laurenpearse/Stage-Top-Incubator/hardware/README.md

# Hardware

- `cad/stage-top-incubator.step`: the 3D-printed PETG enclosure as a STEP file, which opens in most CAD programs (Fusion 360, SolidWorks, FreeCAD, Onshape).
- `bom/initial-component-list-2026-08-27.pdf`: the first component list from August. The final bill of materials (R 13 527) and the full wiring list are in the appendices of the report.

The heater driver and thermistor divider circuits are drawn in the report.
