laurenpearse/Stage-Top-Incubator/report/v_glossary.tex

%---------------------------------------------------------------------
%	List of Acronyms
%   A plain table rather than the glossaries package, so the list prints
%   on any compiler without makeglossaries. Keep it alphabetical, and
%   define each acronym in the text the first time it is used.
%---------------------------------------------------------------------
\chapter{List of Acronyms}
\label{ch:gloss}
\small
\renewcommand{\arraystretch}{1.12}
\begin{longtable}{@{}p{2.4cm} p{0.75\textwidth}@{}}
\toprule
\textbf{Acronym} & \textbf{Meaning} \\
\midrule
\endfirsthead
\toprule
\textbf{Acronym} & \textbf{Meaning} \\
\midrule
\endhead
\bottomrule
\endlastfoot
ACH & Air changes per hour \\
ADC & Analogue-to-digital converter \\
AI & Artificial intelligence \\
ANSI & American National Standards Institute \\
ASTM & ASTM International (formerly American Society for Testing and Materials) \\
BOM & Bill of materials \\
BSL & Biosafety level \\
CAD & Computer-aided design \\
DIY & Do-it-yourself \\
ECSA & Engineering Council of South Africa \\
FOPDT & First order plus dead time \\
FPU & Floating point unit \\
GA & Graduate Attribute \\
I\textsuperscript{2}C & Inter-integrated circuit (serial bus) \\
IDM & Institute of Infectious Disease and Molecular Medicine \\
IEC & International Electrotechnical Commission \\
ITO & Indium tin oxide \\
MMRU & Molecular Mycobacteriology Research Unit \\
MOSFET & Metal-oxide-semiconductor field-effect transistor \\
Mtb & \textit{Mycobacterium tuberculosis} \\
NDIR & Non-dispersive infrared \\
NO & Normally open (relay contact) \\
NTC & Negative temperature coefficient (thermistor) \\
PCB & Printed circuit board \\
PET & Polyethylene terephthalate \\
PETG & Polyethylene terephthalate glycol \\
PI & Proportional-integral \\
PID & Proportional-integral-derivative \\
pp & Percentage points \\
ppm & Parts per million \\
PTC & Positive temperature coefficient \\
PWM & Pulse-width modulation \\
QFT & Quantitative feedback theory \\
RC & Resistance-capacitance (thermal network) \\
RH & Relative humidity \\
RTD & Resistance temperature detector \\
SLAS & Society for Laboratory Automation and Screening \\
SPI & Serial peripheral interface \\
UART & Universal asynchronous receiver-transmitter \\
UCT & University of Cape Town \\
ZAR & South African rand \\
\end{longtable}
\normalsize
