laurenpearse/Stage-Top-Incubator/docs/thesis/latex/0_titlepage.tex

%=====================================================================
%	TITLE PAGE
%=====================================================================
\begin{titlepage}
    \centering
    \vspace*{0cm}

    % Title
    {\huge\bfseries \titl\par}
    \vskip 0.5cm

    % Subtitle
    {\Large \subtitle\par}
    \vskip 0.8cm

    % UCT logo
    \logo

    \vskip 0.8cm

    % Author
    {\Large\bfseries \auth\par}
    \vskip 2mm
    {\normalsize \studentnumber\par}

    % Author's address
    \vskip 2mm
    {\normalsize
        \dept\\*
        \uni\\*
        \city\\*
        \country\par}

    \vskip 0.6cm

    % Supervisor
    {\normalsize
        {\itshape Supervisor}\\*
        \supervisor\par}
    \vskip 0.2cm

    % Co-supervisor
    {\normalsize
        {\itshape Co-supervisor}\\*
        \cosupervisor\par}
    \vskip 0.6cm

    % Date
    {\Large\bfseries \MonthYear\par}
    \vskip 0.5cm

    % Degree
    {\normalsize A \documenttype\ submitted in partial fulfilment of the requirements for the degree of \degreee\ (\degreeabv) in the \dept\ at the \uni.\par}

    \vskip 0.5cm

    \vfill

    % Department logo
    \bottomlogos
\end{titlepage}
