laurenpearse/Stage-Top-Incubator/docs/thesis/latex/A_gitrepo.tex

%---------------------------------------------------------------------
% Appendix: GitHub repository
%---------------------------------------------------------------------
\chapter{GitHub Repository}
\label{app:github}

The firmware, MATLAB and Simulink models, analysis scripts, test data and CAD files for the enclosure are in the project repository:

\begin{center}
    \gitrepo
\end{center}

% TODO: list the top-level folders of the repository here once the link is
% in, e.g. firmware/, simulation/, analysis/, data/, cad/, with one line on
% what each holds, so an examiner can find the code behind each chapter.
