laurenpearse/Stage-Top-Incubator/notes/CO2 Path.pdf

## CO2 Path

^^ first thing i want to have standard sizing throughout, ideally just want one tube size ^^ first gonna see what size the bigger components come in and try pick the same

## CO2 Gas Cost

according to Air Products 2026 price list:
about: R1800

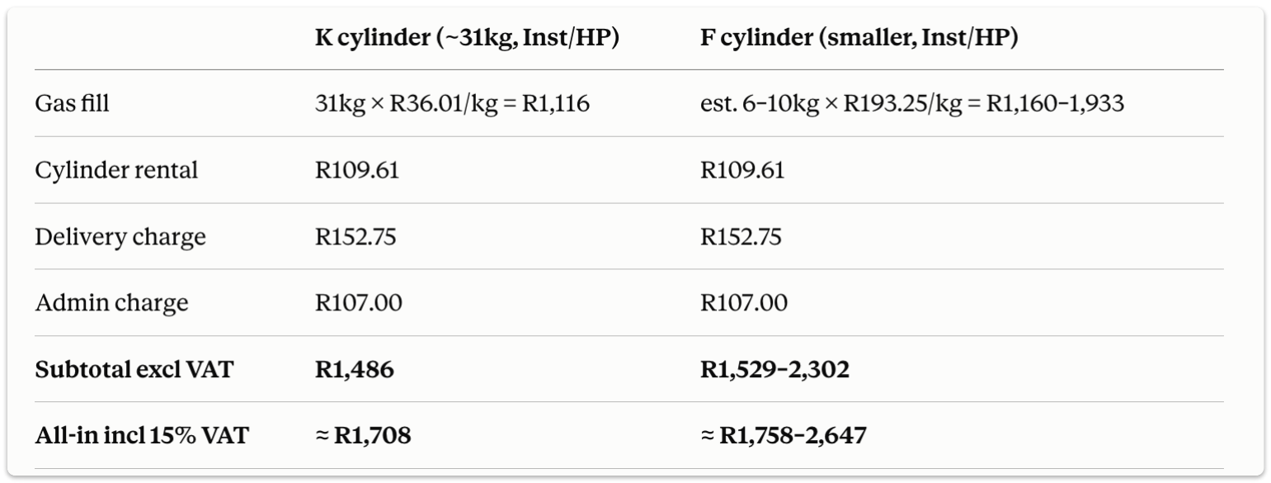
[picture p18: figure]

## 50 000ppm CO2 sensor

## Pressure Regulator

GCE Pressure Regulator Co2, Ar 5/8 in G BSP - R1950 - https://za.rs-online.com/web/p/welding-regulators/0340129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 wcB (https://za.rs-online.com/web/p/welding-regulators/0340129?matchtype=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)

## Solenoid Valve

SMC Solenoid Valve - NC 24V - R1037 - https://za.rs-online.com/web/p/pneumaticsolenoid-valves/0425481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 (https://za.rs-online.com/web/p/pneumatic-solenoid-valves/0425481?matchtype=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)

1. R2162 only reads up to 50000ppm so won't know if overshoot (only reads up to 5%) https://www.robotics.org.za/sensors/co2-sensors/SEN0220
2. R3467 - this CO2 sensor reads up to 100% concentration apparently - https://za.rs-online.com/web/p/environmental-sensor-ics/1809026 (https://za.rs-online.com/web/p/environmental-sensor-ics/1809026)

AIdOaXzb1vUsxvDIeOKC1ISHqEjizdmNSuDv_JVTC_cY6xhKBxMwfqbtBQ0aAnsaEALw_wc
B (https://za.rs-online.com/web/p/pneumatic-solenoid-valves/0425481?matchtype=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)

## Flow control/needle valve Check valve

^^^ Option that Includes: Regulator, solenoid, needle valve, check valve

## Tubing

## Compression fitting / bulkhead connector

Bulkhead
Connector

RS PRO
PMM
Series
Pneumatic
Fitting, 6
mm Push-in, 6 mm
Push-in

RS
Online
2 | R134 | R268 | https://za.rs-onlin _-2351214&match rTUBhAiEiwADv8g (https://za.rs-online.com/web/p/pneumatic-fittings/2351214?matchtype=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)

regulator, solenoid, fine tune valve, check valve, Connector: G5/8 : R1628, https://mcmerwe.co.za/shop/lst-aqua-co2-dual-gauge-regulator/,
would rather go for this because it invludes a bunch of componentsd I need and in one unit that is proved to ork togteher - it's less expesnive and less risky and It is local so i can go fetch it myself and talk with the vendors to clarify it will work

for mcmerwe one - tube R75: https://mcmerwe.co.za/shop/aquapro-co2-pressureresistant-tube-3m/ (https://mcmerwe.co.za/shop/aquapro-co2-pressure-resistant-tube-3m/)
