laurenpearse/Stage-Top-Incubator/report/B_ethics.tex

%---------------------------------------------------------------------
% Appendix: Ethics approval
%---------------------------------------------------------------------
\chapter{Ethics Approval}
\label{app:ethics}

The project was submitted to the Faculty Research Ethics Committee pre-screening questionnaire before any testing began. The outcome letter (reference \ebeethicsnumber{}, 11 August 2026) confirms that a full ethics application was not needed. The letter is shown below.

\begin{center}
    \fbox{}
\end{center}
