laurenpearse/Stage-Top-Incubator/report/i_declaration.tex

%---------------------------------------------------------------------
%	Plagiarism Declaration
%   Wording follows the EEE4022S 2026 declaration issued by the course
%   convener, including the statement on the use of AI.
%---------------------------------------------------------------------
\chapter{Plagiarism Declaration}
\label{ch:decl}

\begin{enumerate}[label=\arabic*., leftmargin=*, itemsep=6pt]
    \item I know that plagiarism is wrong. Plagiarism is to use another's work and pretend that it is one's own.

    \item I have used the \textbf{IEEE} convention for citation and referencing. Each contribution to, and quotation in, this report from the work(s) of other people has been attributed, and has been cited and referenced. Any section taken from an internet source has been referenced to that source.

    \item This report is my own work, and is in my own words (except where I have attributed it to others).

\item \textbf{I have not paid a third party to complete my work on my behalf. My use of artificial intelligence software has been limited to} the use of Anthropic's Claude (claude.ai) as a writing, editing and coding aid. It was used to shorten and reword long passages and fix \LaTeX\ problems. It was also used to help write the STM32 code for reading the sensors and implementing the controllers, and to organise design notes into a more coherent form to write from. All engineering decisions, component selection, modelling, experiments, data and results are my own. Every AI-assisted passage and code section was checked against my data and sources and edited by me before it was included. Examples of the prompts used and the output received are given in Appendix~\ref{app:ai}.

    \item I have not allowed and will not allow anyone to copy my work with the intention of passing it off as his or her own work.

    \item I acknowledge that copying someone else's assignment or essay, or part of it, is wrong, and declare that this is my own work.
\end{enumerate}

\vfill
%---------------------------------------------------------------------
% WORD COUNT, PAGE COUNT AND SIGNATURE
%   Both counts are computed, not typed. See latexmkrc and 0_main.tex.
%---------------------------------------------------------------------
\noindent
\begin{minipage}[b]{0.55\textwidth}
\begin{tabular}{@{}ll@{}}
\textbf{Word count} & \wordcount{} words\\
\textbf{Page count} & \bodypages{} pages\\
\multicolumn{2}{@{}l}{\footnotesize (body chapters only, excluding preamble, appendices and bibliography)}
\end{tabular}
\end{minipage}\hfill
\begin{minipage}[b]{0.4\textwidth}
    \raggedleft
%   figs/signature.jpg is still the template's placeholder X.
%   Replace it with a scan of your own signature before submitting.
    \textbf{Signed}\quad\par
    \vskip 1mm
    \textbf{\auth}, \studentnumber\par
    {\footnotesize \dept\\ \uni\par}
    \vskip 1mm
    \FullDate
\end{minipage}
\vspace{2em}
