laurenpearse/Stage-Top-Incubator/docs/thesis/latex/C_topicdescription.tex

%=====================================================================
%   APPENDIX: TOPIC DESCRIPTION
%   The topic as issued in the EEE4022S 2026 topic list (RAV2026-07),
%   before the problem was refined.
%=====================================================================
\chapter{Topic Description}
\label{app:topic}

The original topic description for RAV2026-07, from the EEE4022S 2026 topic list, is shown on the following pages. The topic was refined during the project, and the final problem statement is in Section~\ref{sec:problem-statement}. The main changes were that humidity was measured but not controlled, and that testing was done on the bench instead of on the microscope, so no live \textit{M. smegmatis} sample was imaged (Section~\ref{sec:scope}).

\includepdf[pages=-, scale=0.88, frame, pagecommand={\thispagestyle{plain}}]{pdfs/topic_description_RAV2026-07.pdf}
