laurenpearse/Stage-Top-Incubator/notes/meeting-notes.md

# Meeting notes

One section per meeting — date, who was there, what was discussed, what to do before the next one.

---

## YYYY-MM-DD — Mandy / Robyn

**Discussed:**
-

**Action items:**
-

**Next meeting:**
-
