laurenpearse/Stage-Top-Incubator/notes/scratchpad.md

# Scratchpad

Running notes — newest entries on top. Doesn't need to be tidy or complete sentences.

---

## 2026-08-27

- Repo scaffolded (firmware / hardware / docs / data / scripts / notes).
- Literature review chapter drafted — trimming for sentence length and the repeated "this suggests..." transition before it goes to supervisors.
- Open question: Ragazzini et al. (2019) is paywalled — only have abstract/methods. Try to get full text before relying on their cost/accuracy numbers in the final draft.
