laurenpearse/Stage-Top-Incubator/data/03-closed-loop/fig_C2_setpoint_sweep.png

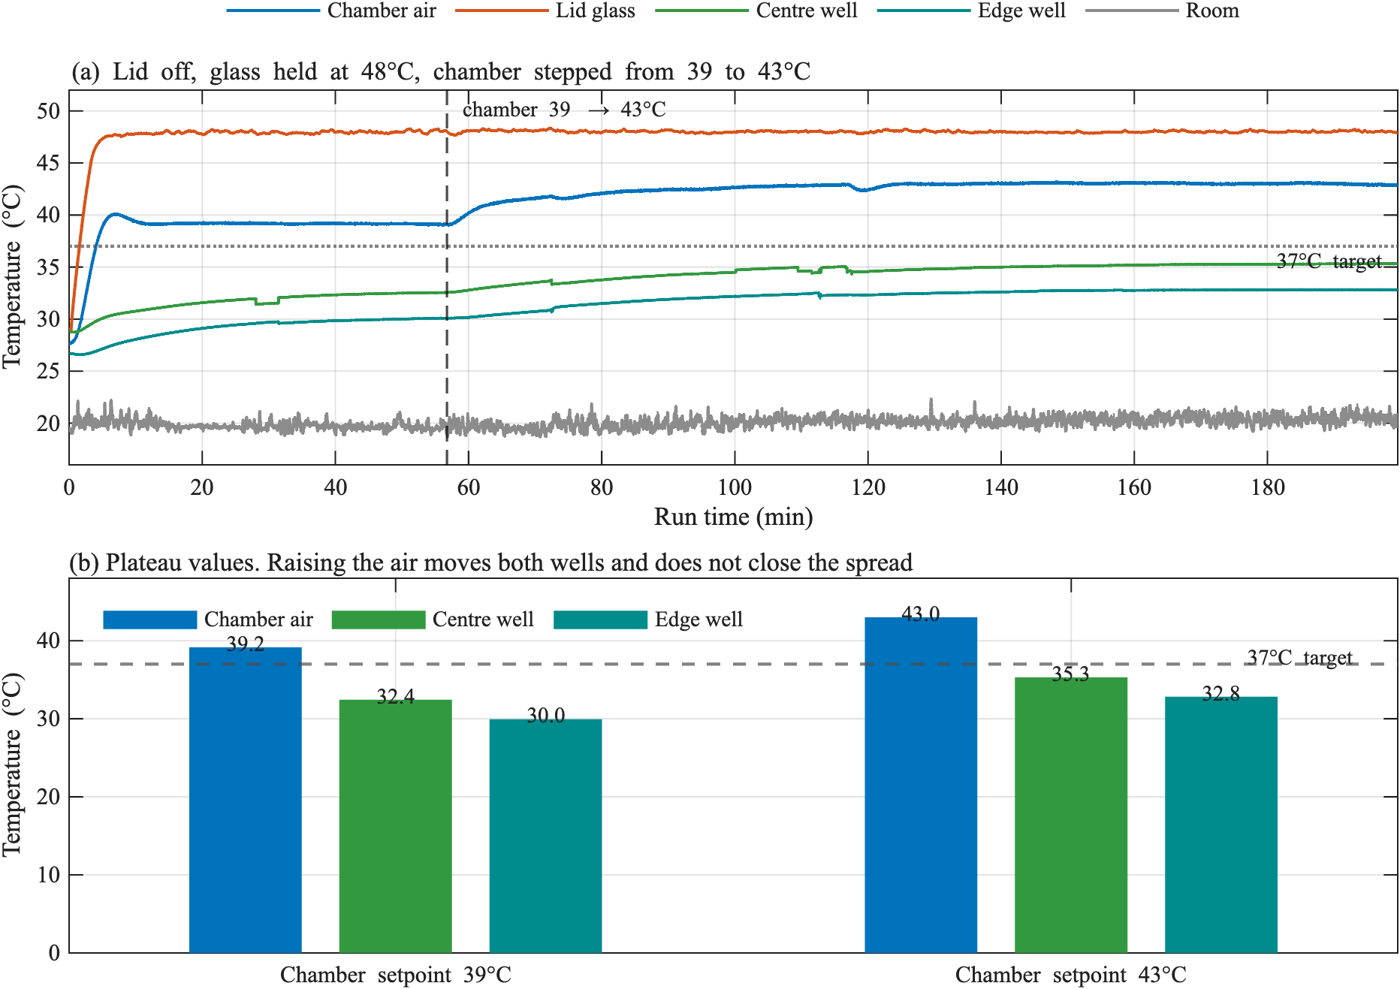
data/03-closed-loop/fig_C2_setpoint_sweep.png
