laurenpearse/Stage-Top-Incubator/data/04-humidity-long-run/earlier-figures/fig_humidity_dewpoint.png

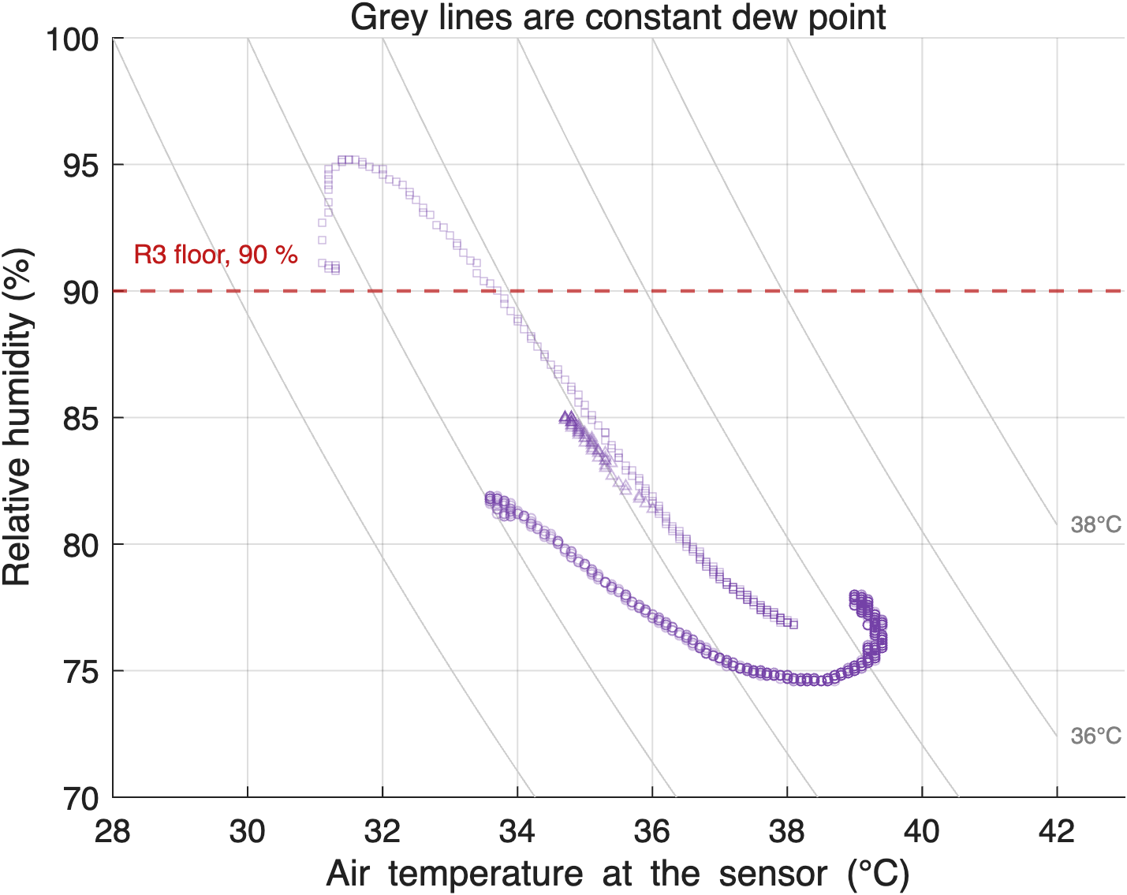
data/04-humidity-long-run/earlier-figures/fig_humidity_dewpoint.png
