laurenpearse/Stage-Top-Incubator/data/04-humidity-long-run/earlier-figures/fig_humidity_run.png

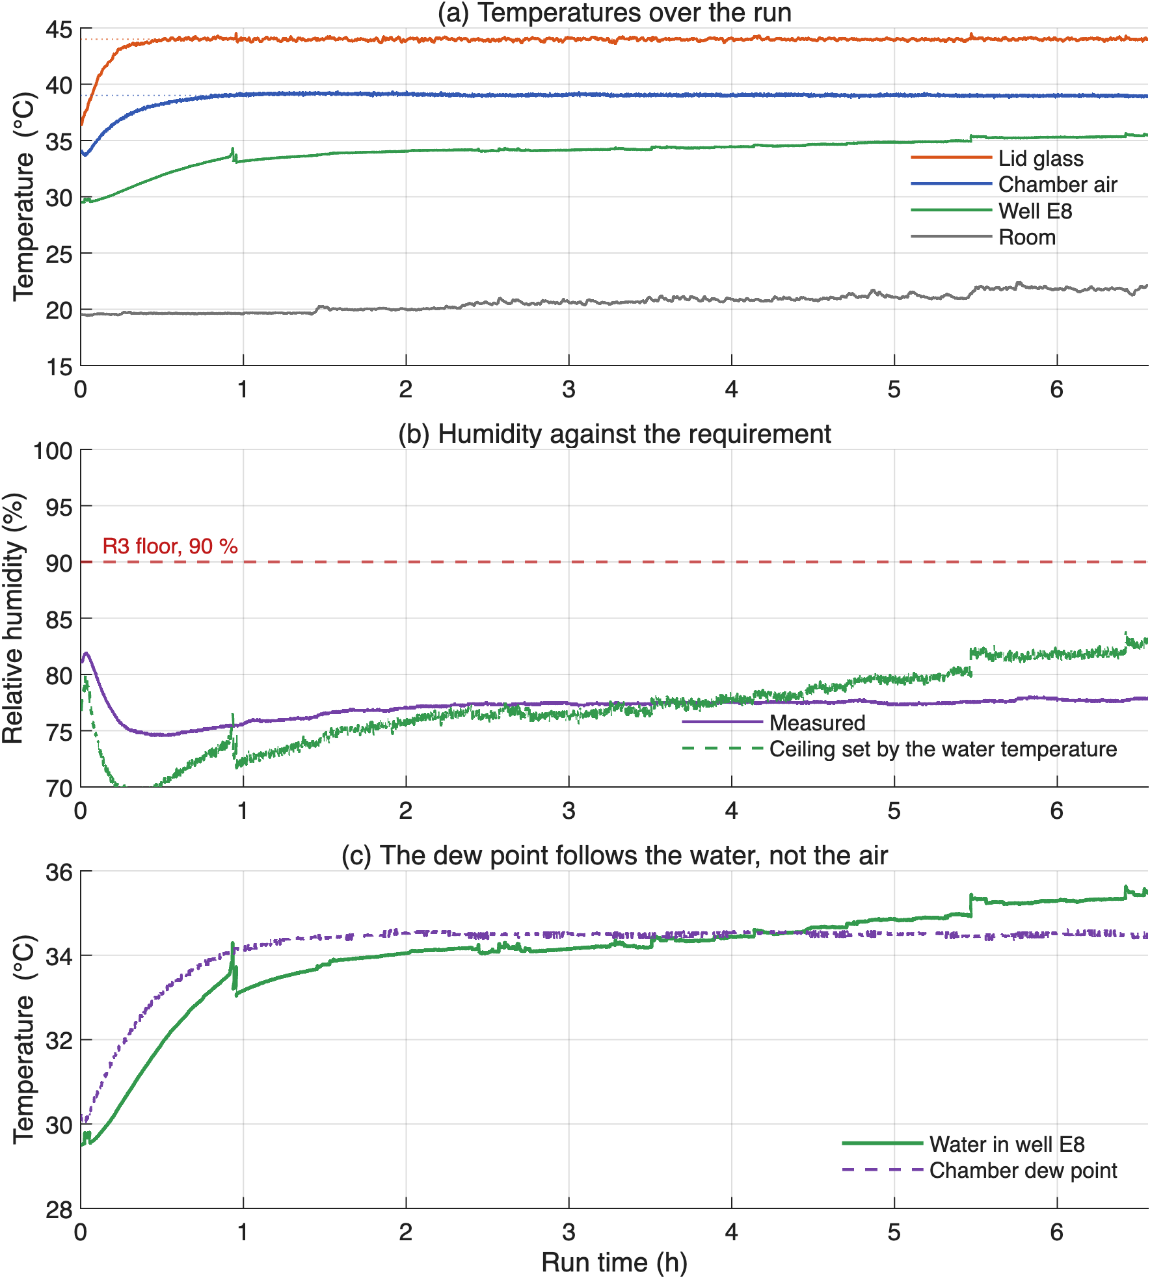
data/04-humidity-long-run/earlier-figures/fig_humidity_run.png
