laurenpearse/Stage-Top-Incubator/data/04-humidity-long-run/fig_H2_dewpoint.png

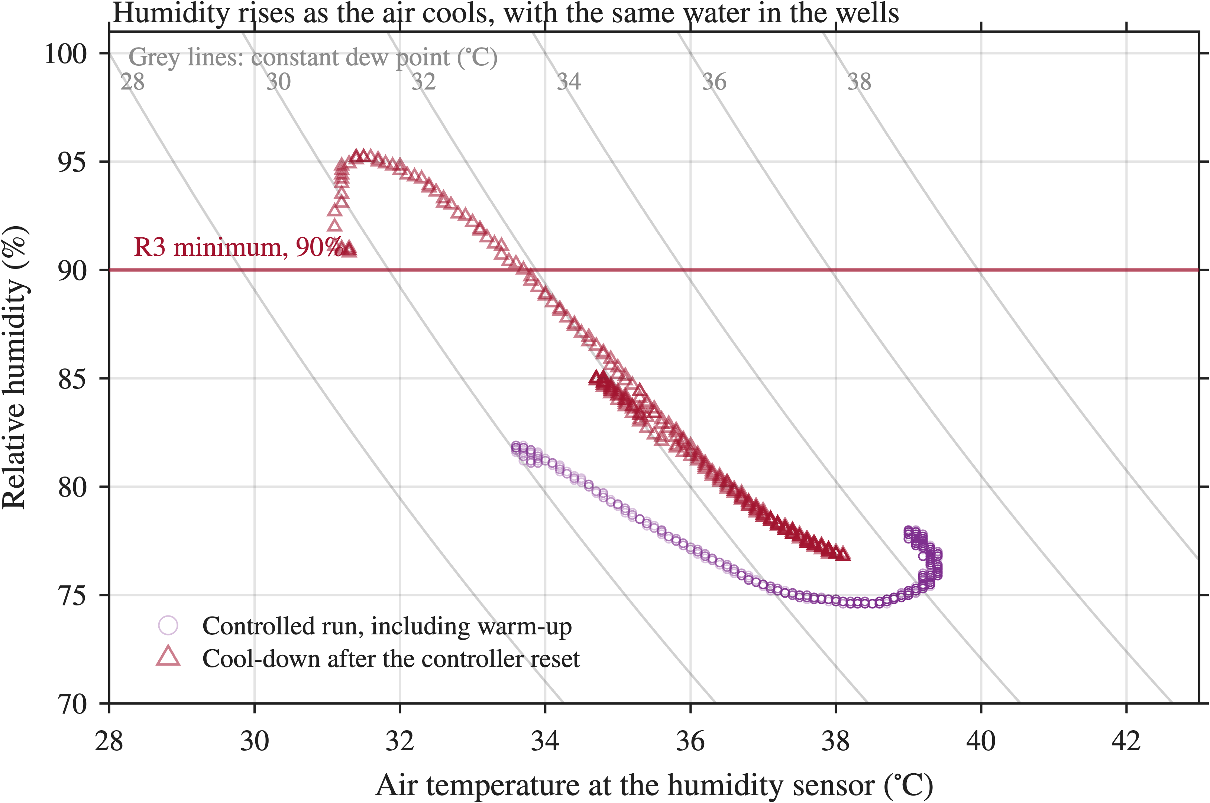
data/04-humidity-long-run/fig_H2_dewpoint.png
