laurenpearse/Stage-Top-Incubator/data/04-humidity-long-run/fig_H3_restart.png

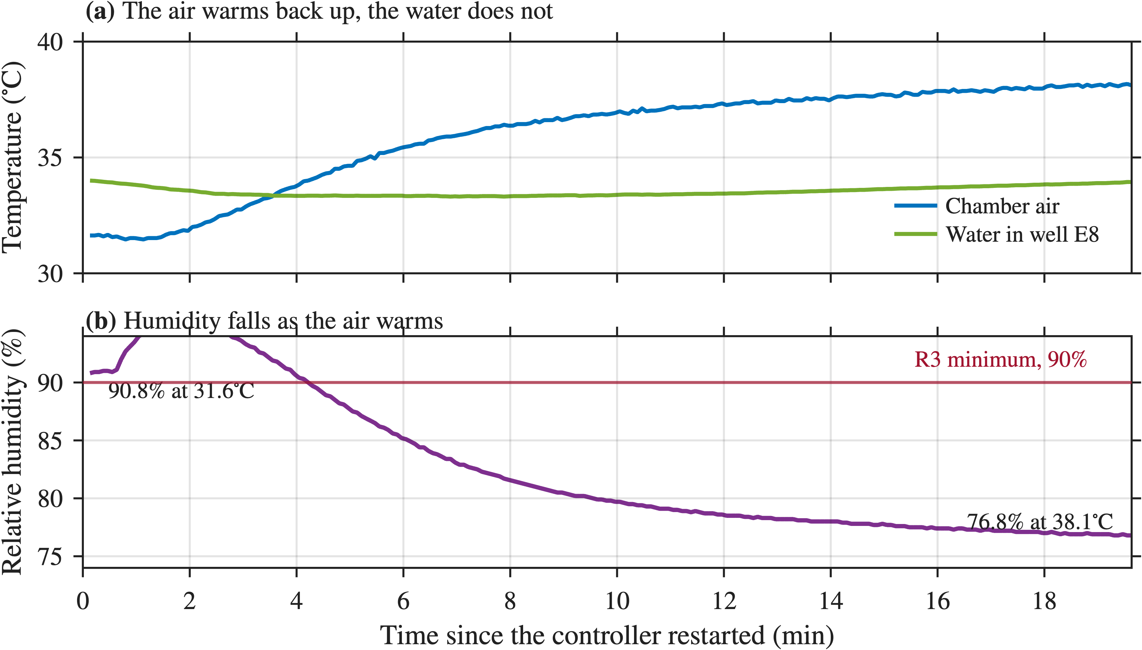
data/04-humidity-long-run/fig_H3_restart.png
