laurenpearse/Stage-Top-Incubator/docs/thesis/latex/figs/ch5/fig_M3_gas_sensors.png

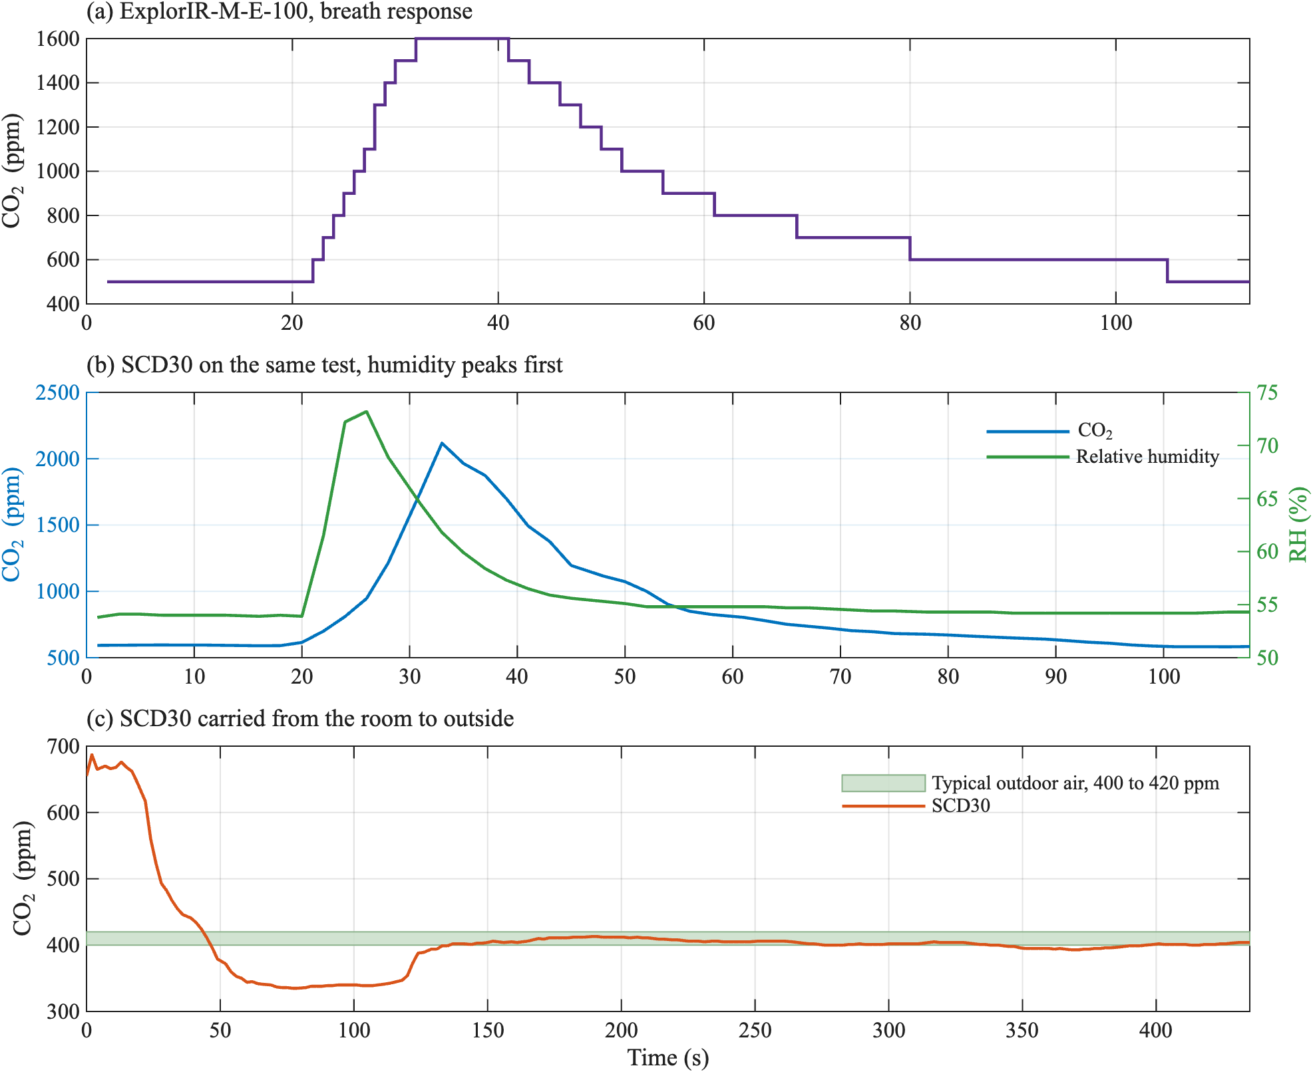
docs/thesis/latex/figs/ch5/fig_M3_gas_sensors.png
