laurenpearse/Stage-Top-Incubator/docs/thesis/latex/figs/ch8/fig_H2_dewpoint.png

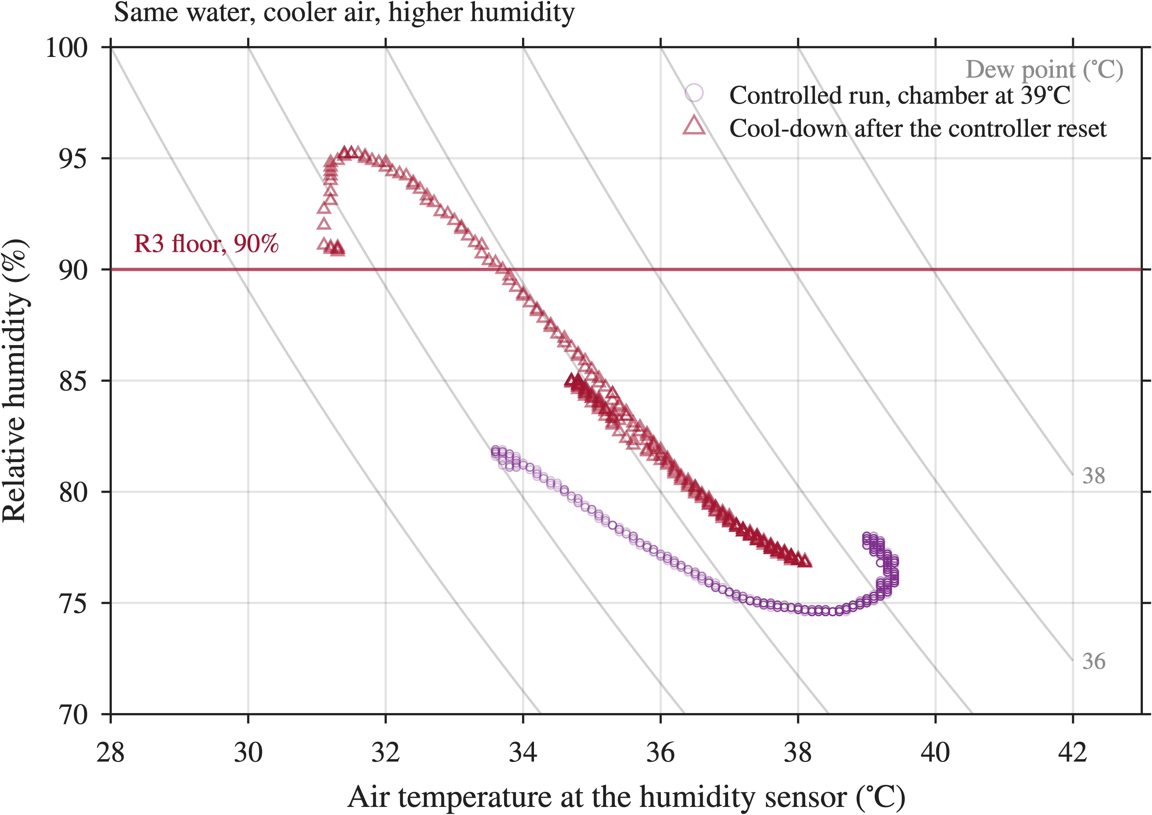
docs/thesis/latex/figs/ch8/fig_H2_dewpoint.png
