laurenpearse/Stage-Top-Incubator/docs/thesis/latex/figs/Control Simulation Figures/fig_C5_robustness.png

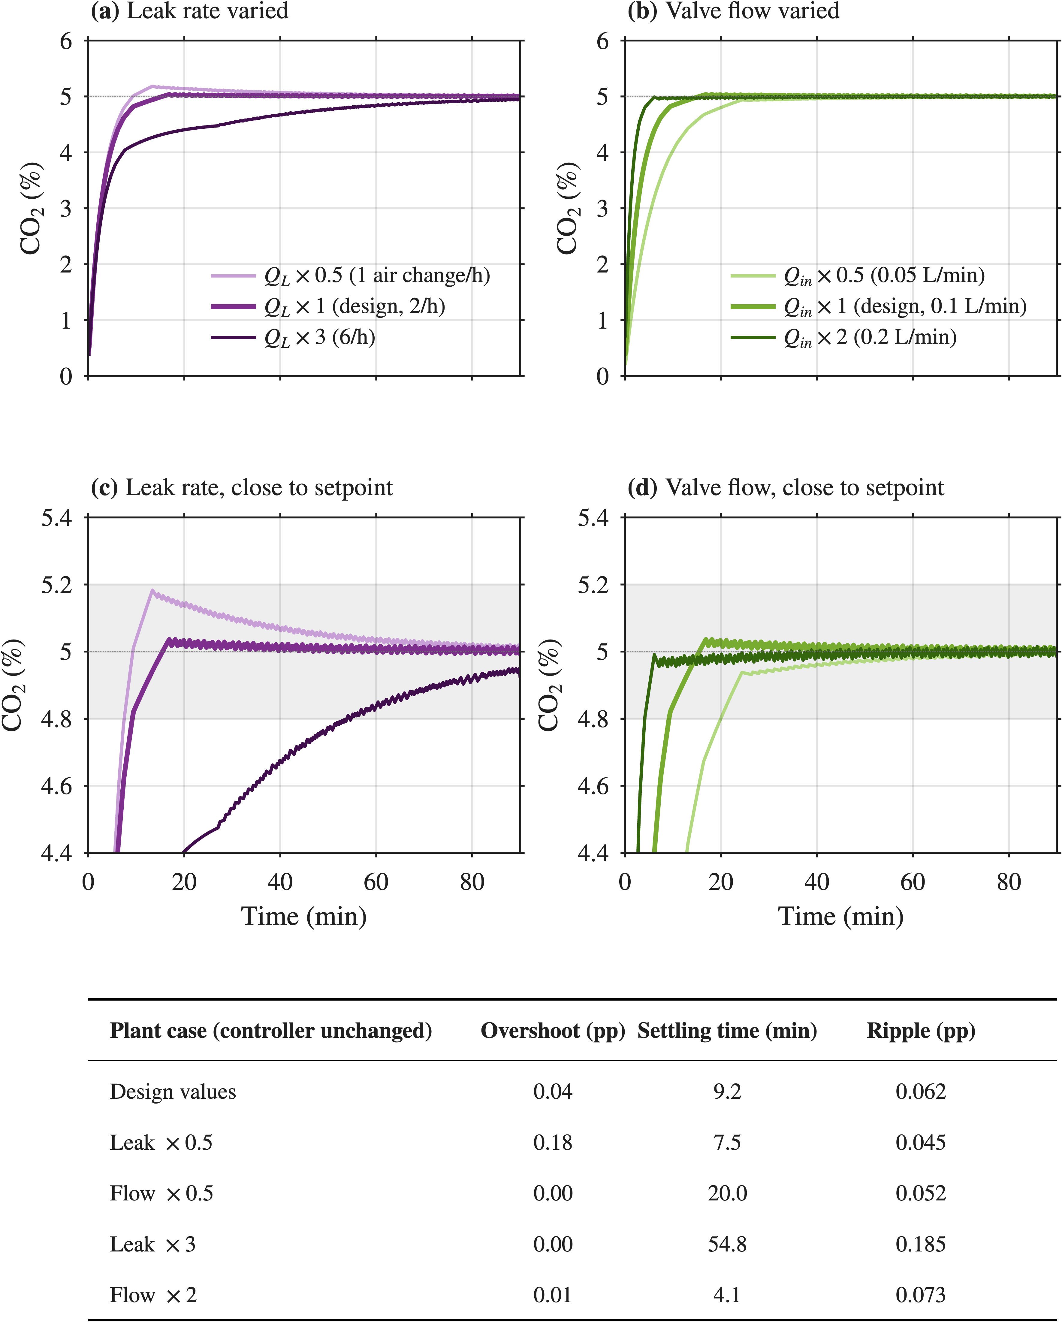
docs/thesis/latex/figs/Control Simulation Figures/fig_C5_robustness.png
