laurenpearse/Stage-Top-Incubator/docs/thesis/latex/figs/Control Simulation Figures/fig_T9_discrete_vs_continuous.png

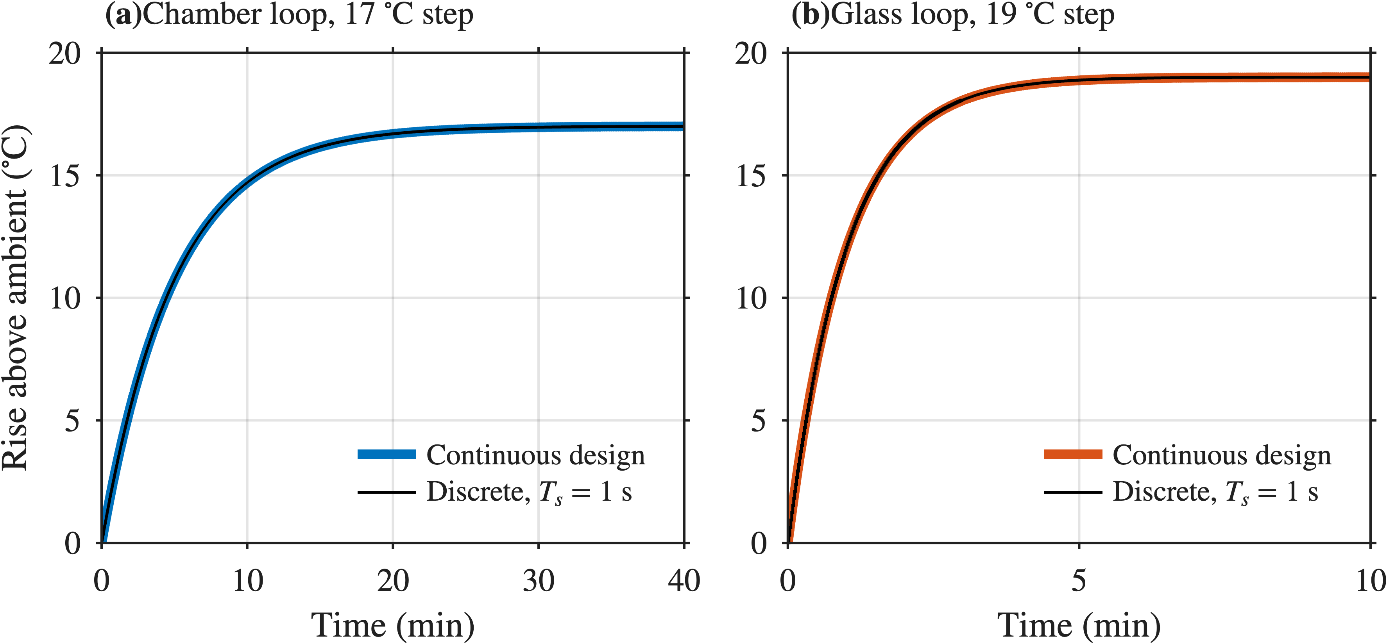
docs/thesis/latex/figs/Control Simulation Figures/fig_T9_discrete_vs_continuous.png
