laurenpearse/Stage-Top-Incubator/docs/thesis/latex/figs/Lit Review/controlmethods.png

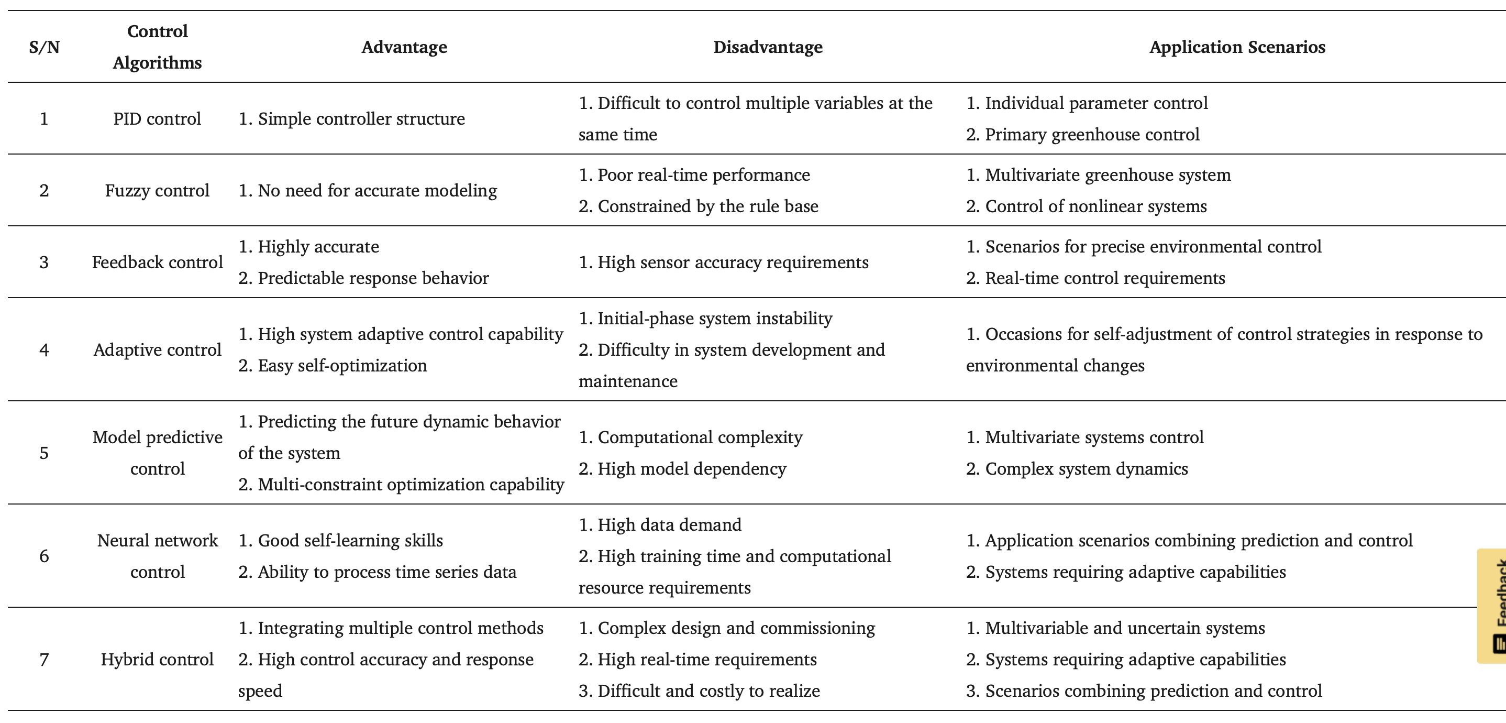
docs/thesis/latex/figs/Lit Review/controlmethods.png
