laurenpearse/Stage-Top-Incubator/docs/thesis/latex/figs/Lit Review/Ibidi.jpg

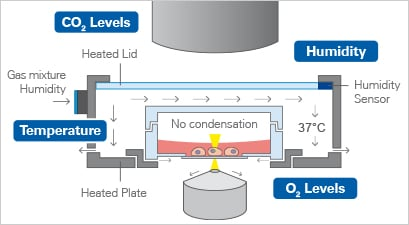
docs/thesis/latex/figs/Lit Review/Ibidi.jpg
