laurenpearse/Stage-Top-Incubator/report/figs/ch4/incubator_section.jpg

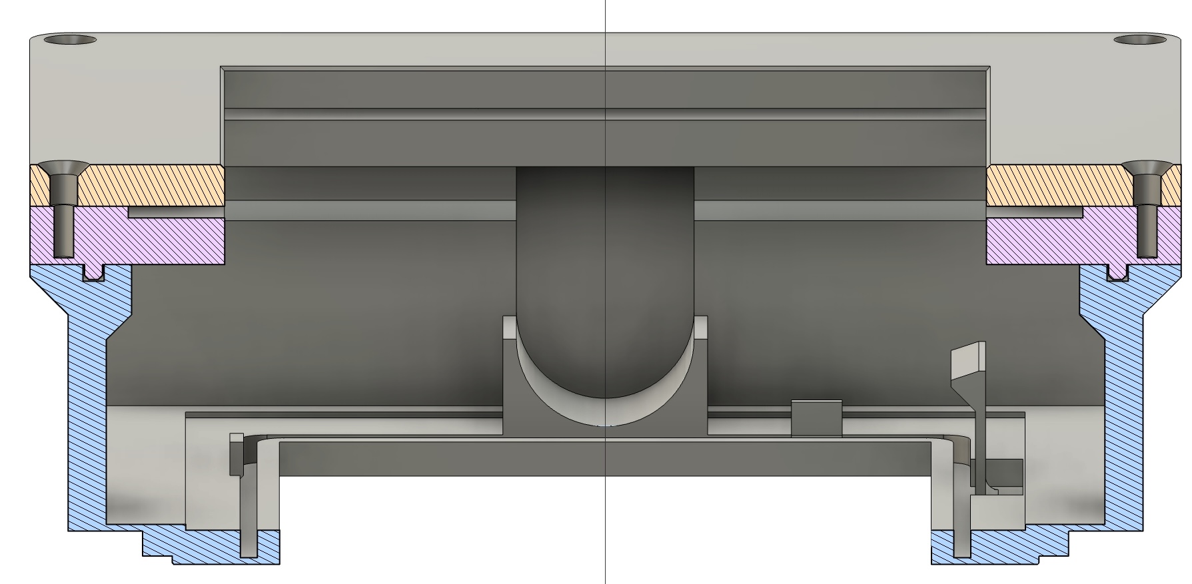
report/figs/ch4/incubator_section.jpg
