laurenpearse/Stage-Top-Incubator/report/figs/ch5/fig_M2_pt1000_icebath.png

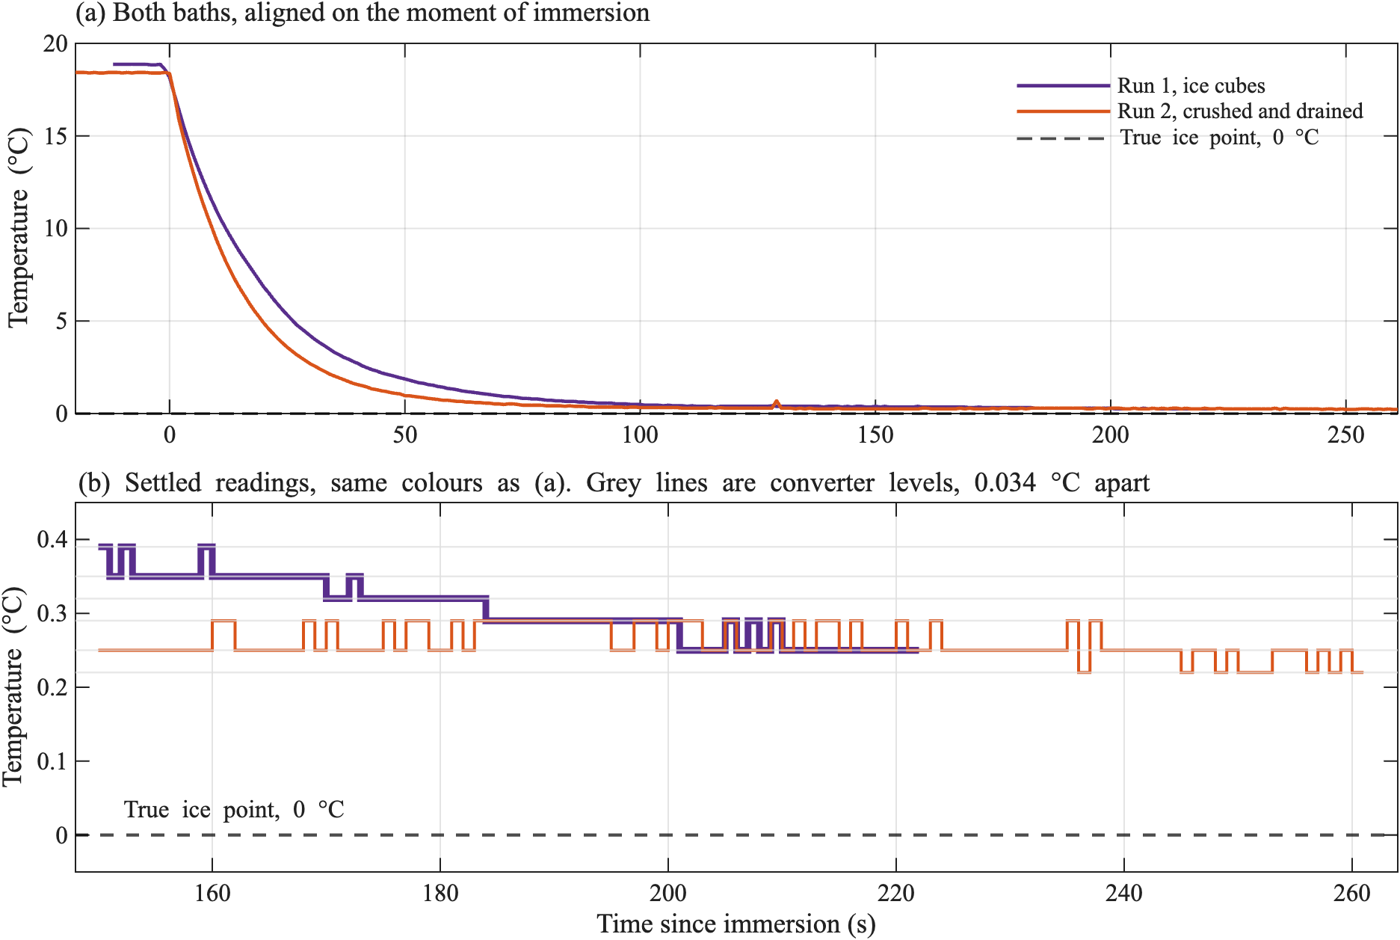
report/figs/ch5/fig_M2_pt1000_icebath.png
