laurenpearse/Stage-Top-Incubator/report/figs/ch7/fig_C3_heated_base.png

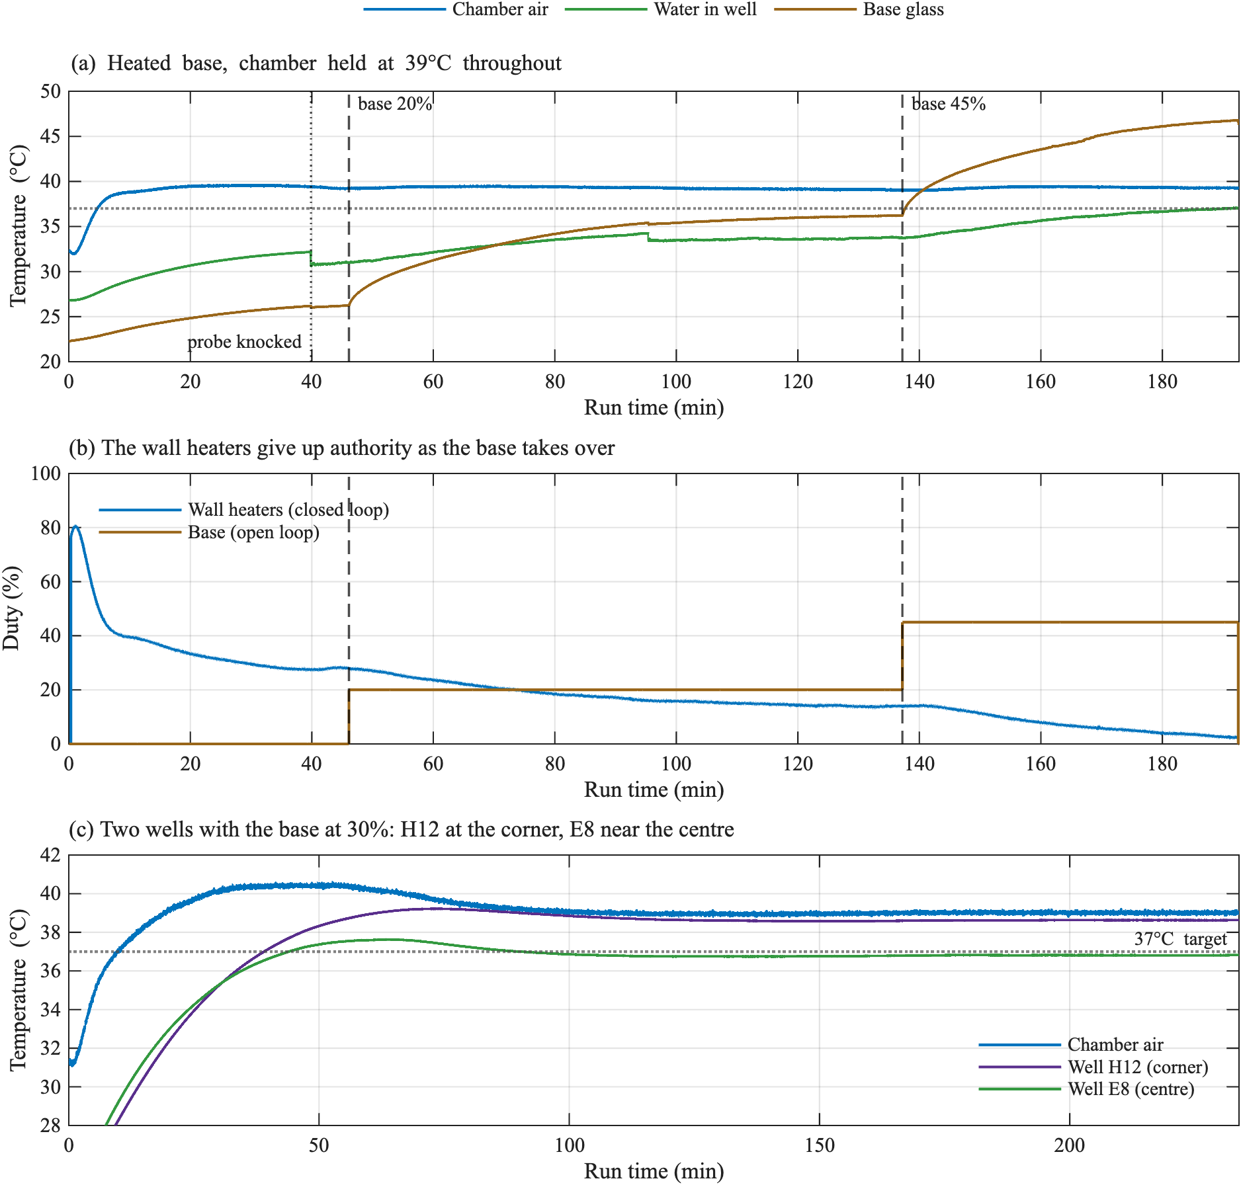
report/figs/ch7/fig_C3_heated_base.png
