laurenpearse/Stage-Top-Incubator/report/figs/ch8/CO2 leak.jpeg

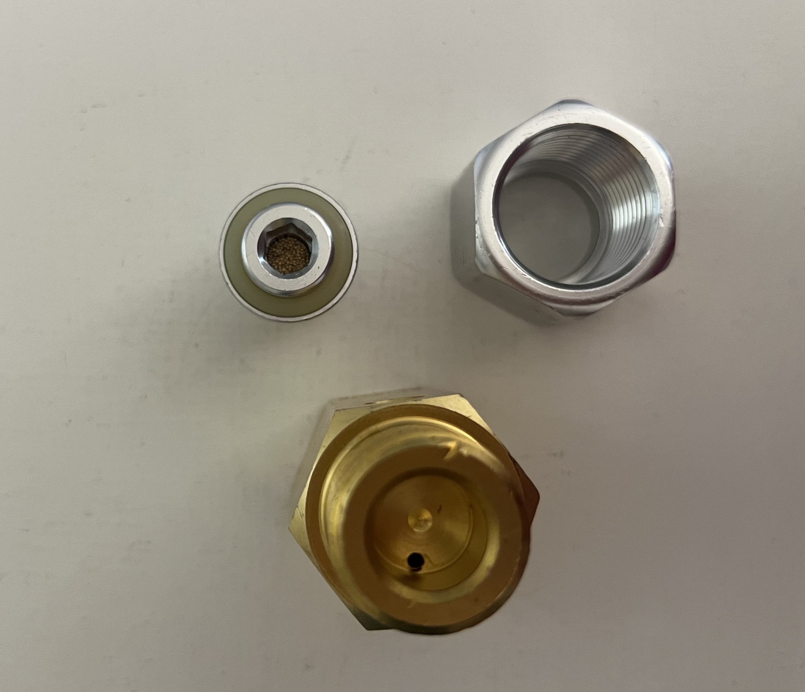
report/figs/ch8/CO2 leak.jpeg
