laurenpearse/Stage-Top-Incubator/simulation/chamber-and-glass/figures/fig_T1_simulink.png

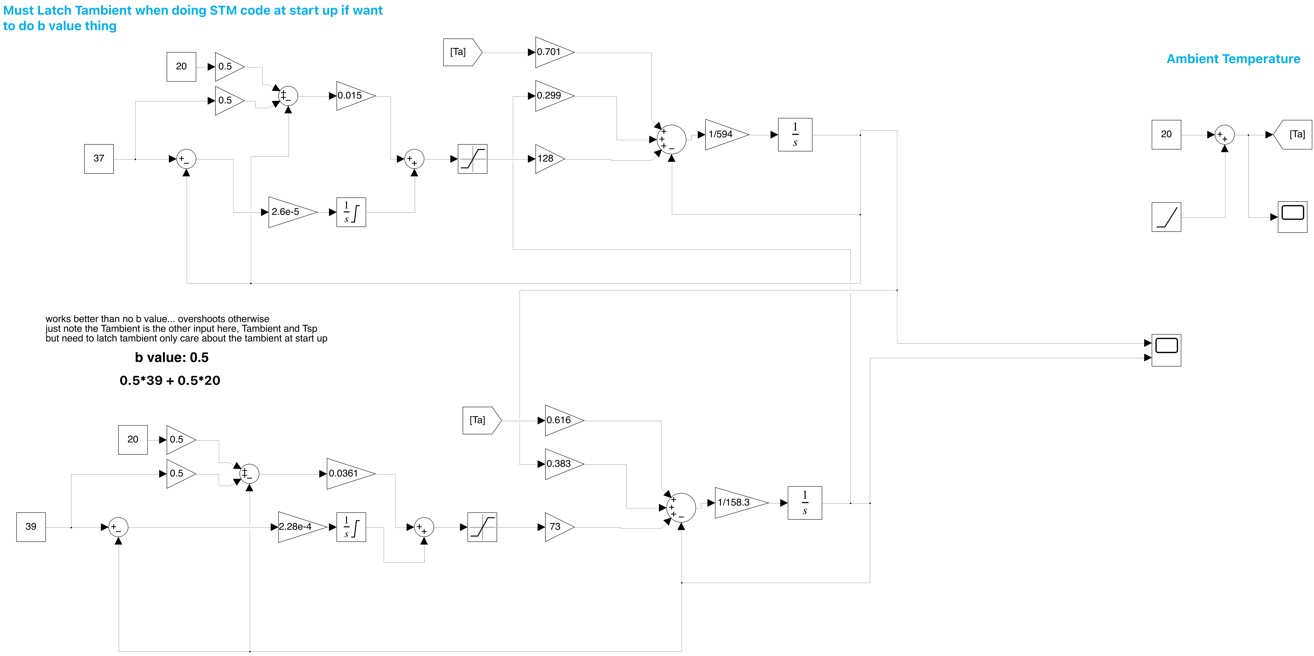
simulation/chamber-and-glass/figures/fig_T1_simulink.png
