laurenpearse/Stage-Top-Incubator/simulation/chamber-and-glass/figures/fig_T4_setpoint_weighting.png

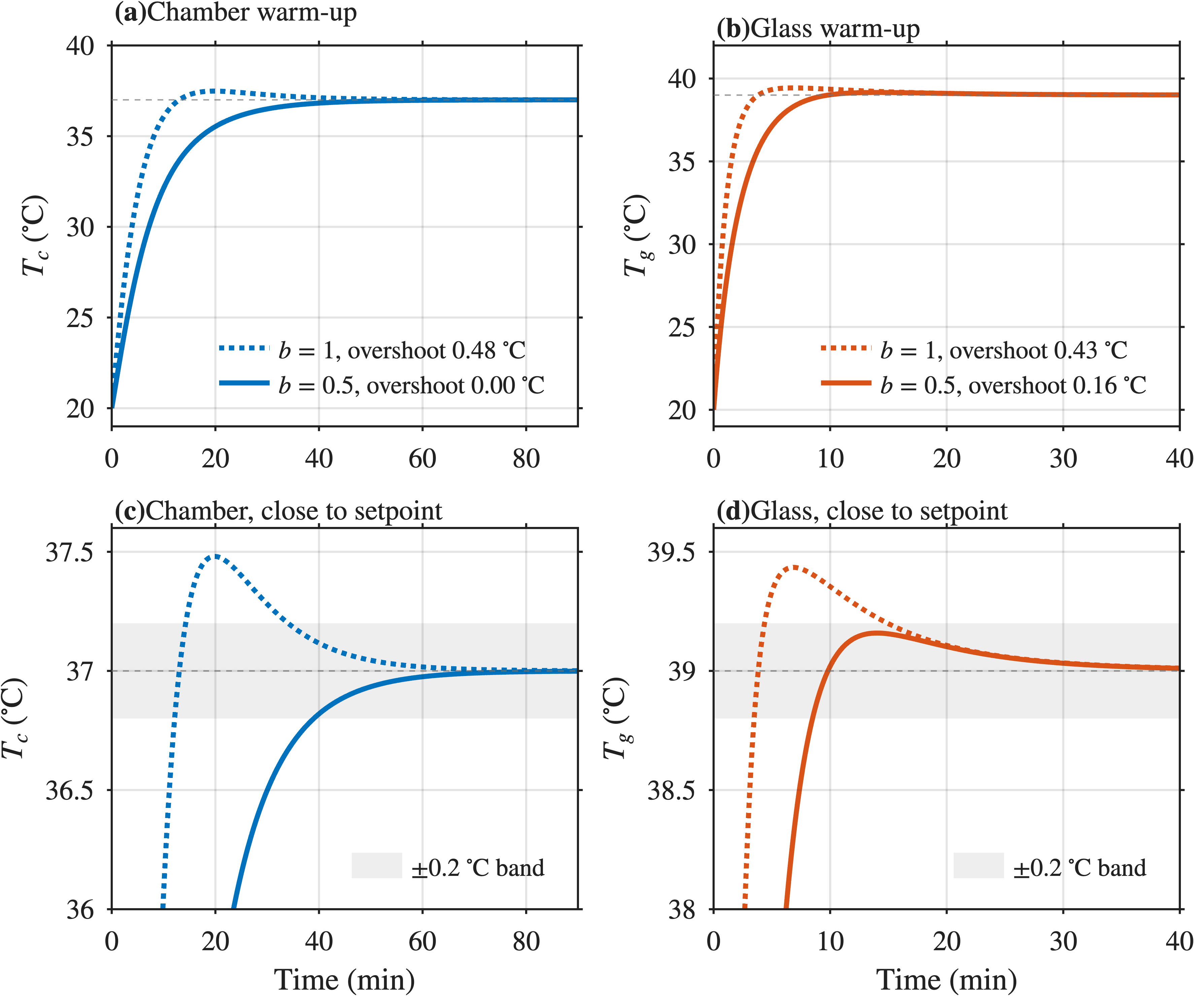
simulation/chamber-and-glass/figures/fig_T4_setpoint_weighting.png
