laurenpearse/Stage-Top-Incubator/simulation/chamber-and-glass/figures/fig_T5_ambient_disturbances.png

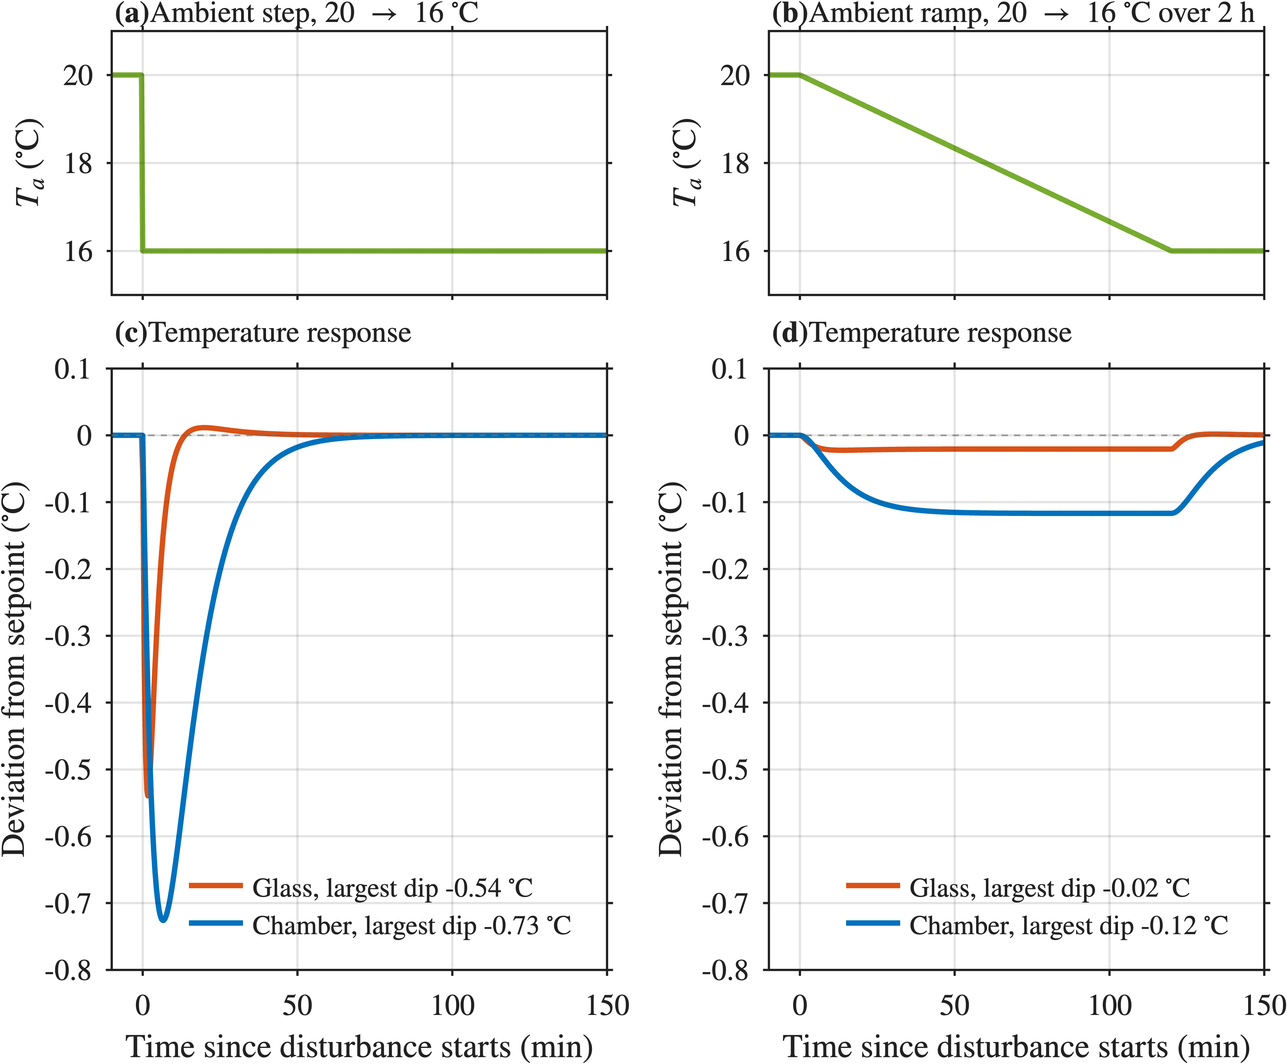
simulation/chamber-and-glass/figures/fig_T5_ambient_disturbances.png
