laurenpearse/Stage-Top-Incubator/simulation/chamber-and-glass/figures/fig_T6_robustness.png

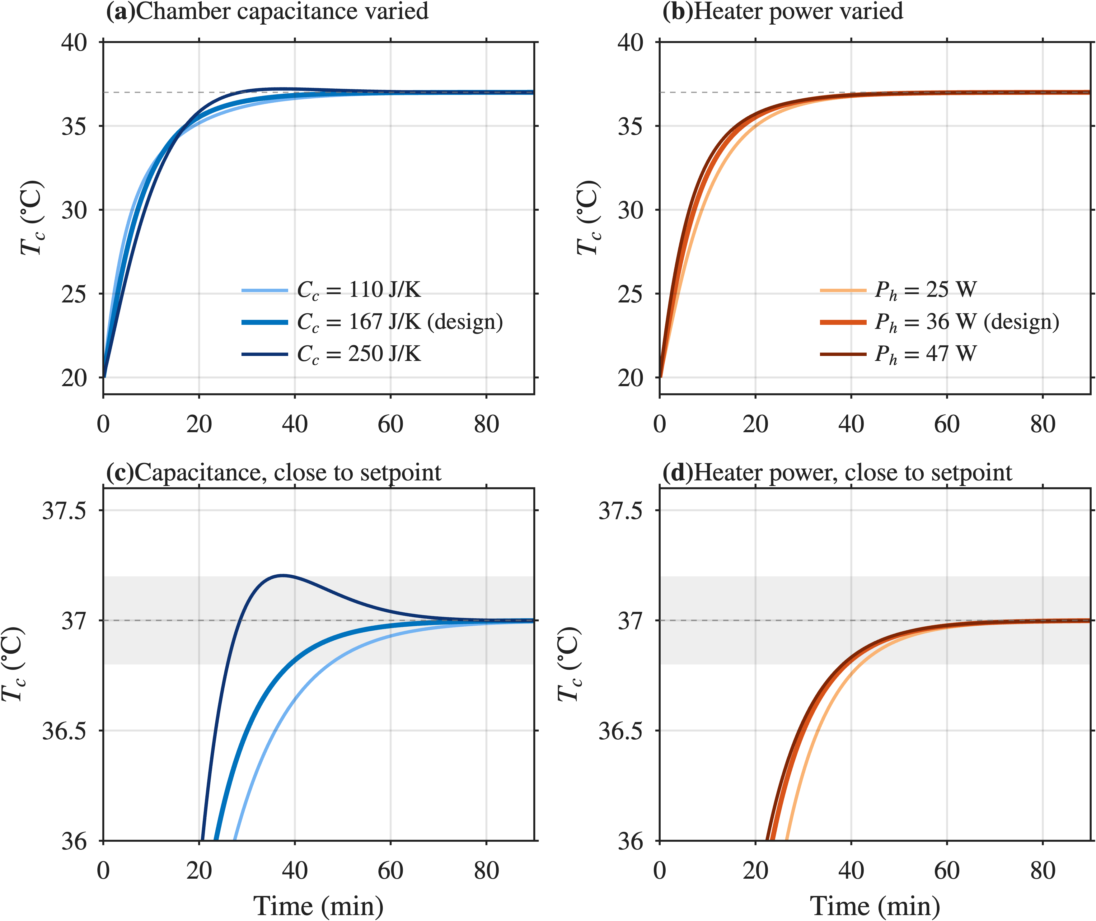
simulation/chamber-and-glass/figures/fig_T6_robustness.png
