laurenpearse/Stage-Top-Incubator/simulation/chamber-and-glass/figures/fig_T7_glass_fixed_vs_coupled.png

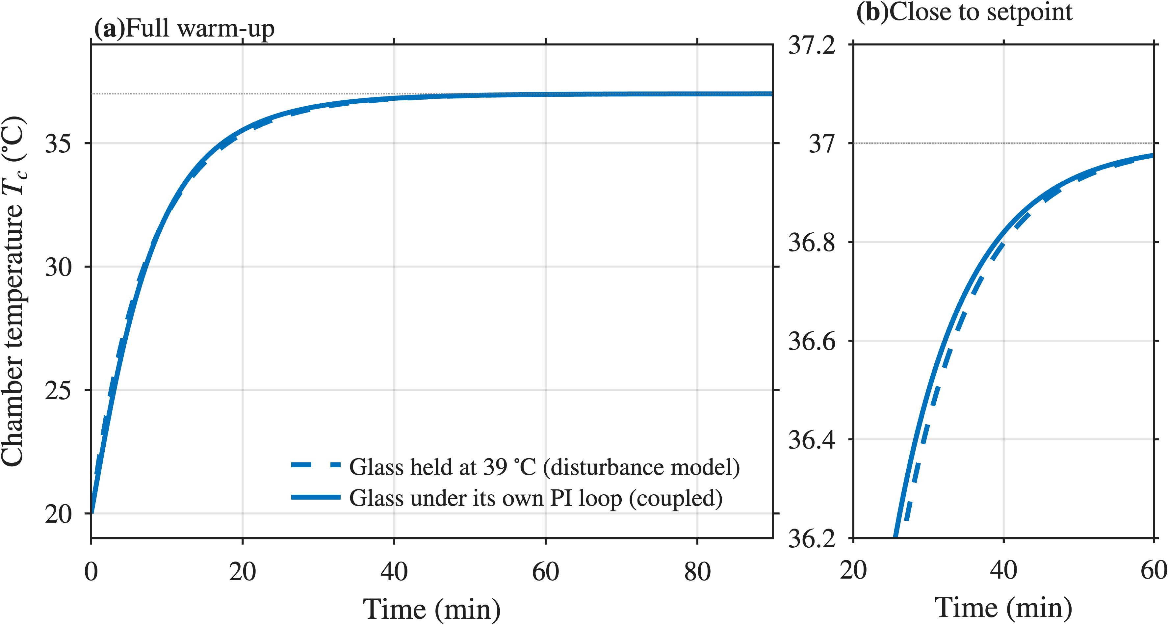
simulation/chamber-and-glass/figures/fig_T7_glass_fixed_vs_coupled.png
