laurenpearse/Stage-Top-Incubator/simulation/chamber-and-glass/figures/Simulink Block Diagram Chamber and Glass.png

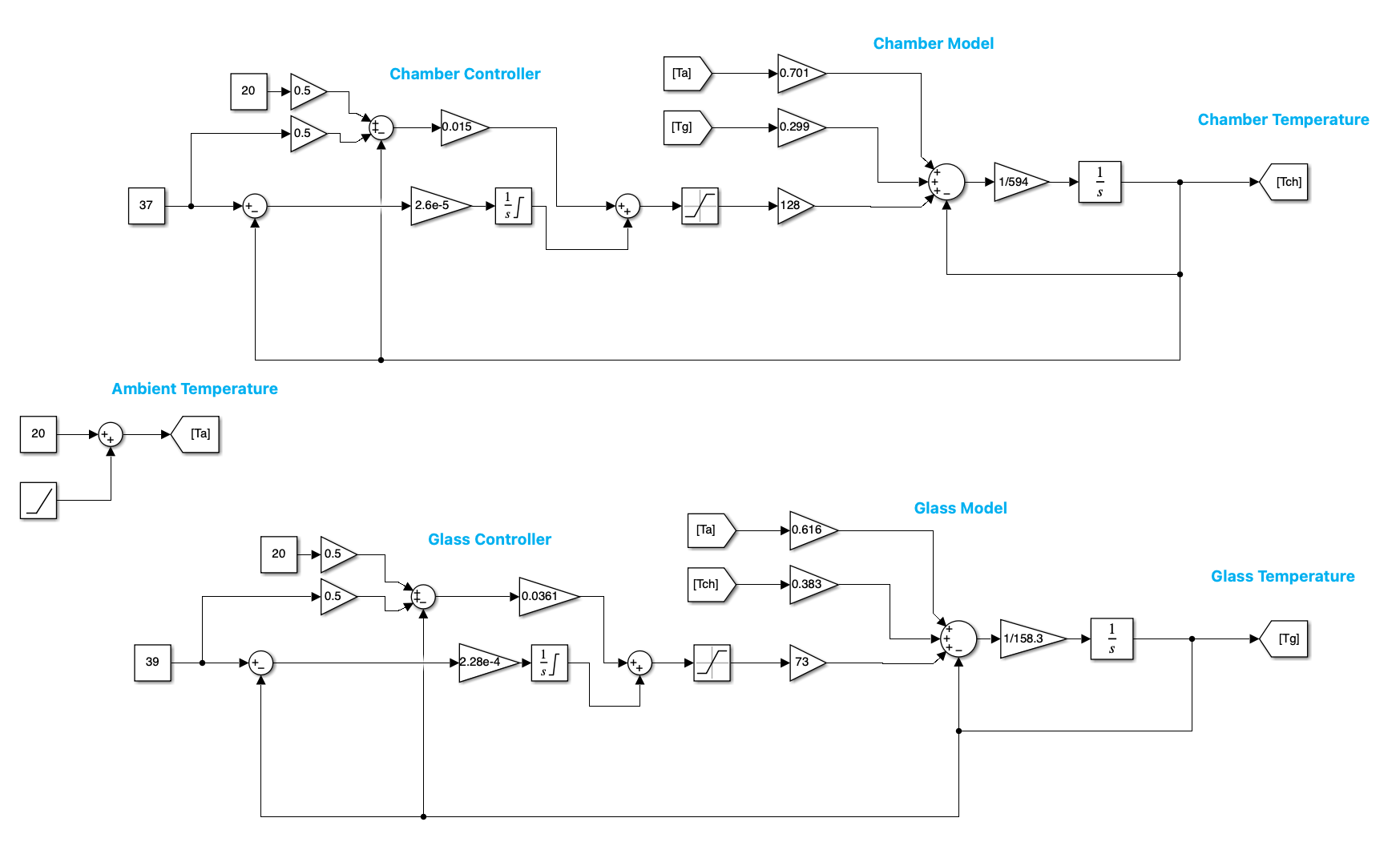
simulation/chamber-and-glass/figures/Simulink Block Diagram Chamber and Glass.png
