laurenpearse/Stage-Top-Incubator/simulation/chamber-and-glass/figures/What Each Figure Is.png

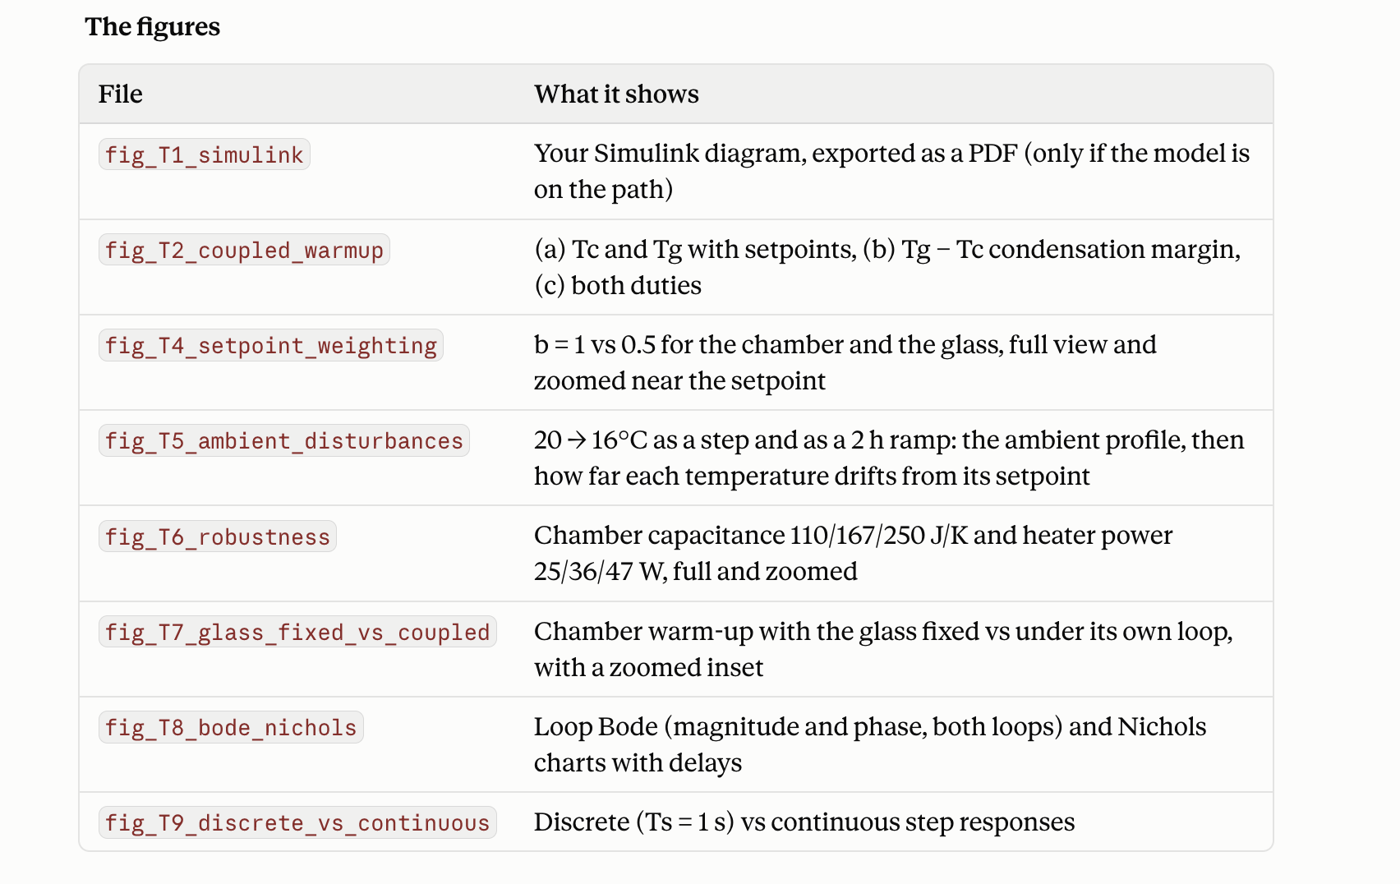
simulation/chamber-and-glass/figures/What Each Figure Is.png
