laurenpearse/Stage-Top-Incubator/simulation/chamber/if chamber faster 1.png

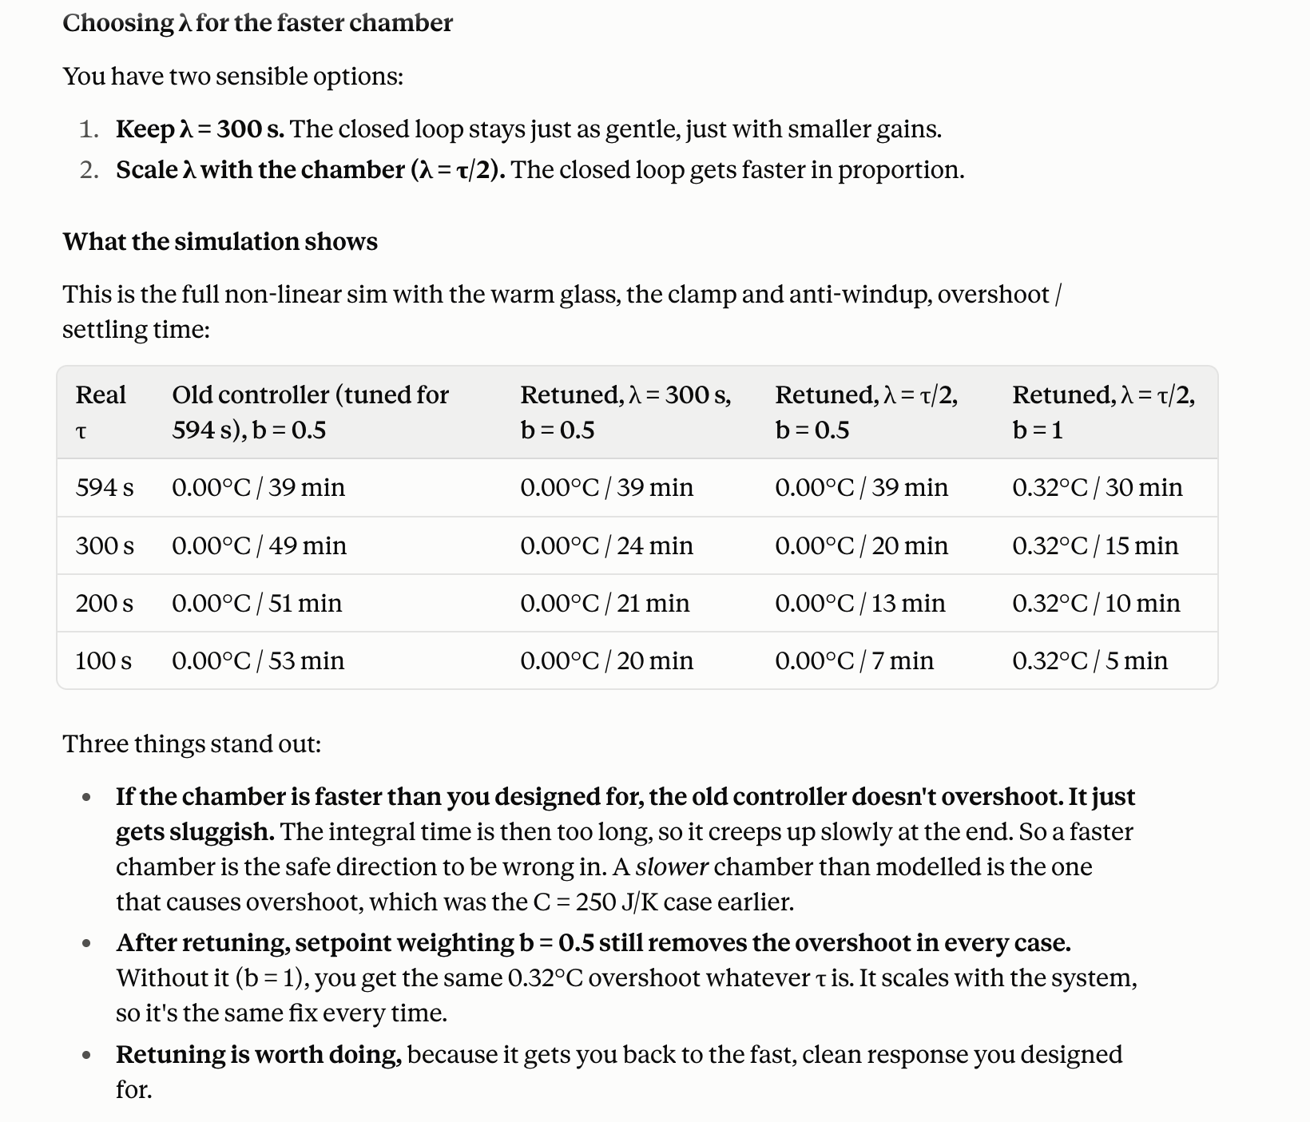
simulation/chamber/if chamber faster 1.png
