laurenpearse/Stage-Top-Incubator/simulation/chamber/if chamber faster 2.png

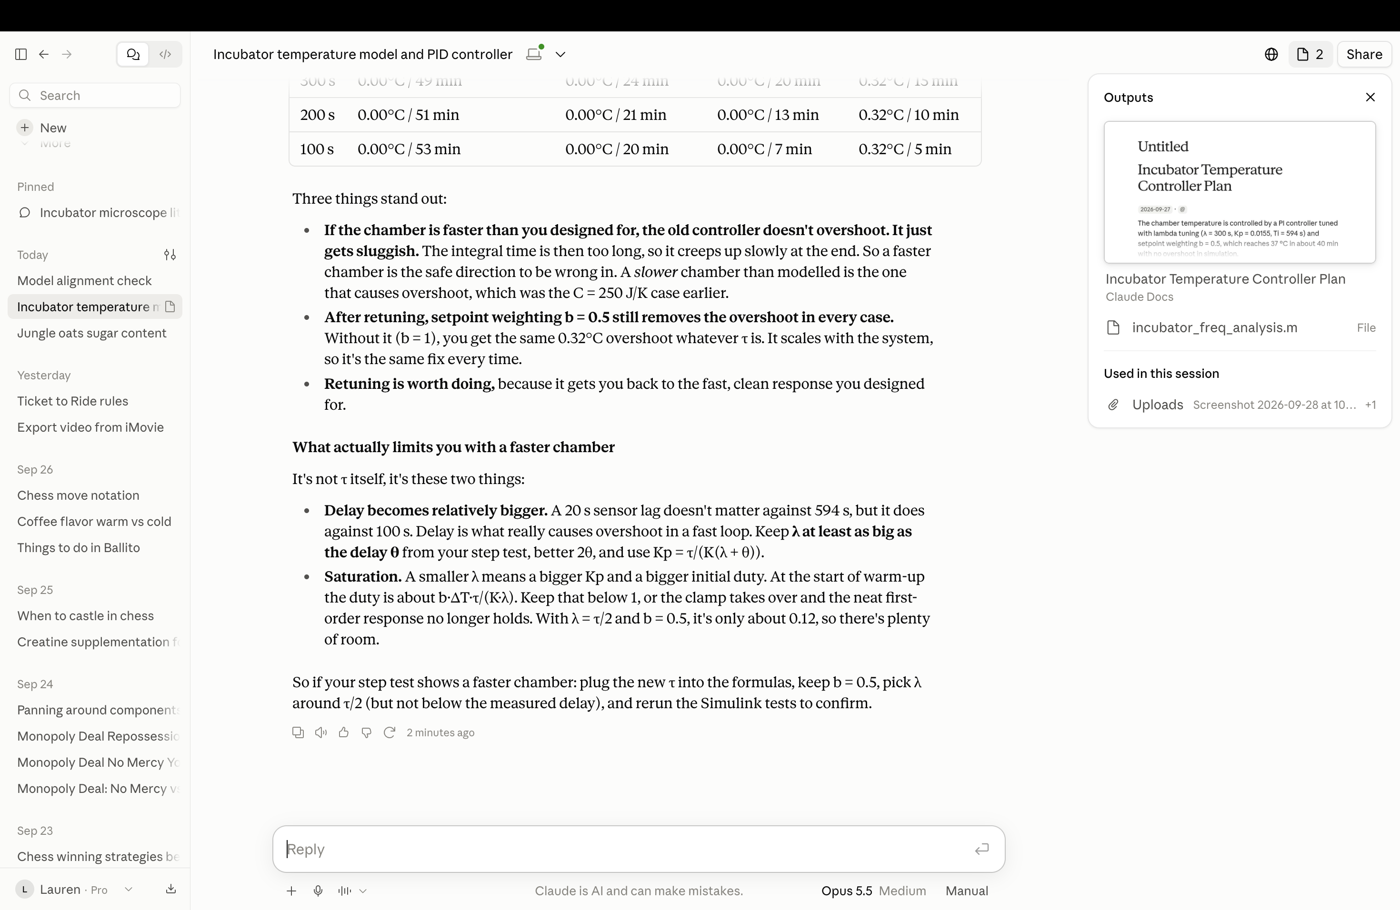
simulation/chamber/if chamber faster 2.png
