laurenpearse/Stage-Top-Incubator/simulation/chamber/if wanted to add the b value.png

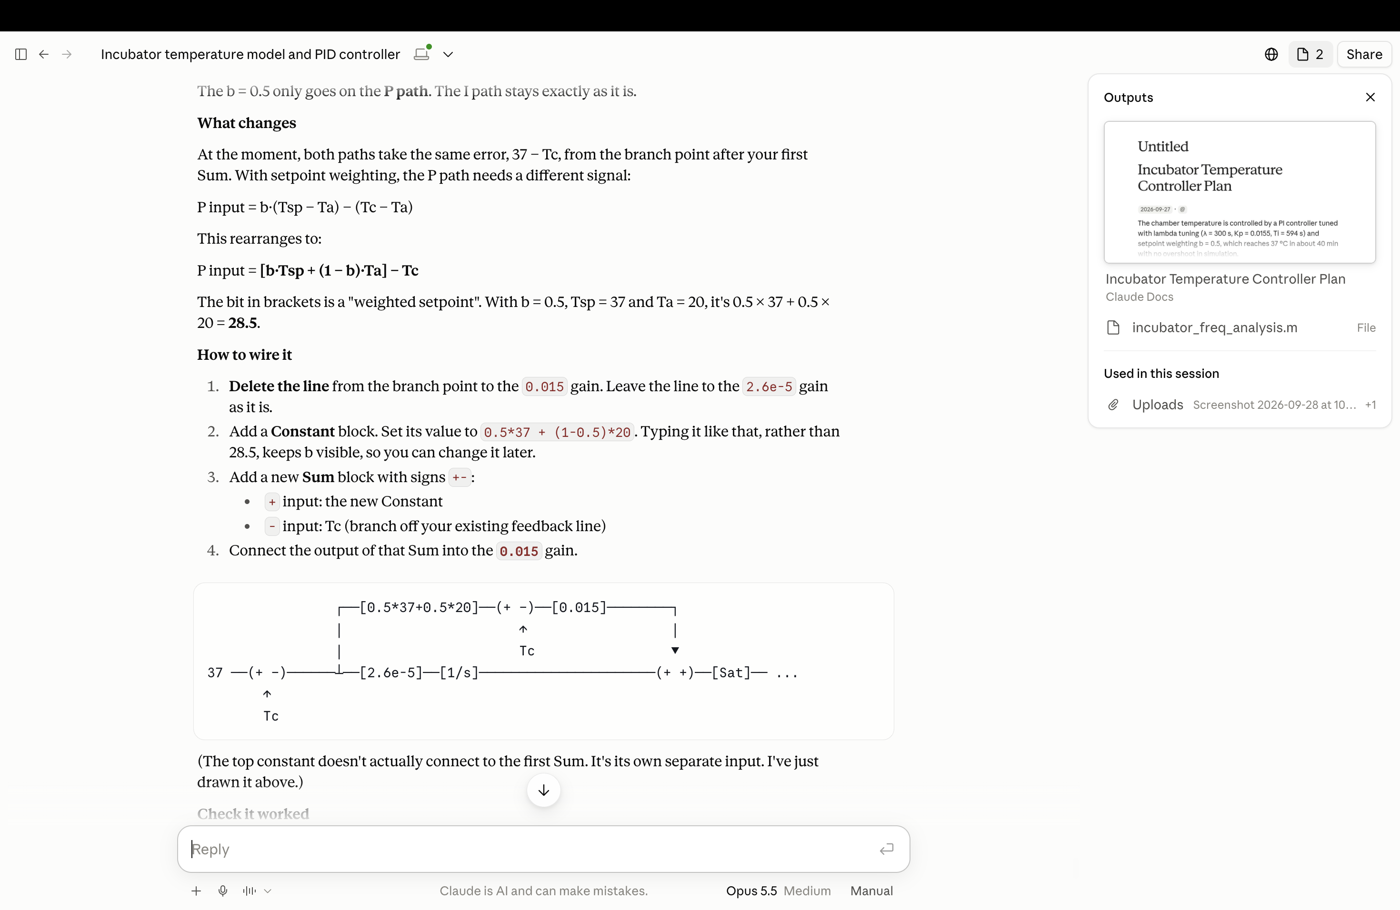
simulation/chamber/if wanted to add the b value.png
