laurenpearse/Stage-Top-Incubator/simulation/co2/figures/updated/NEW_fig_C1_simulink.png

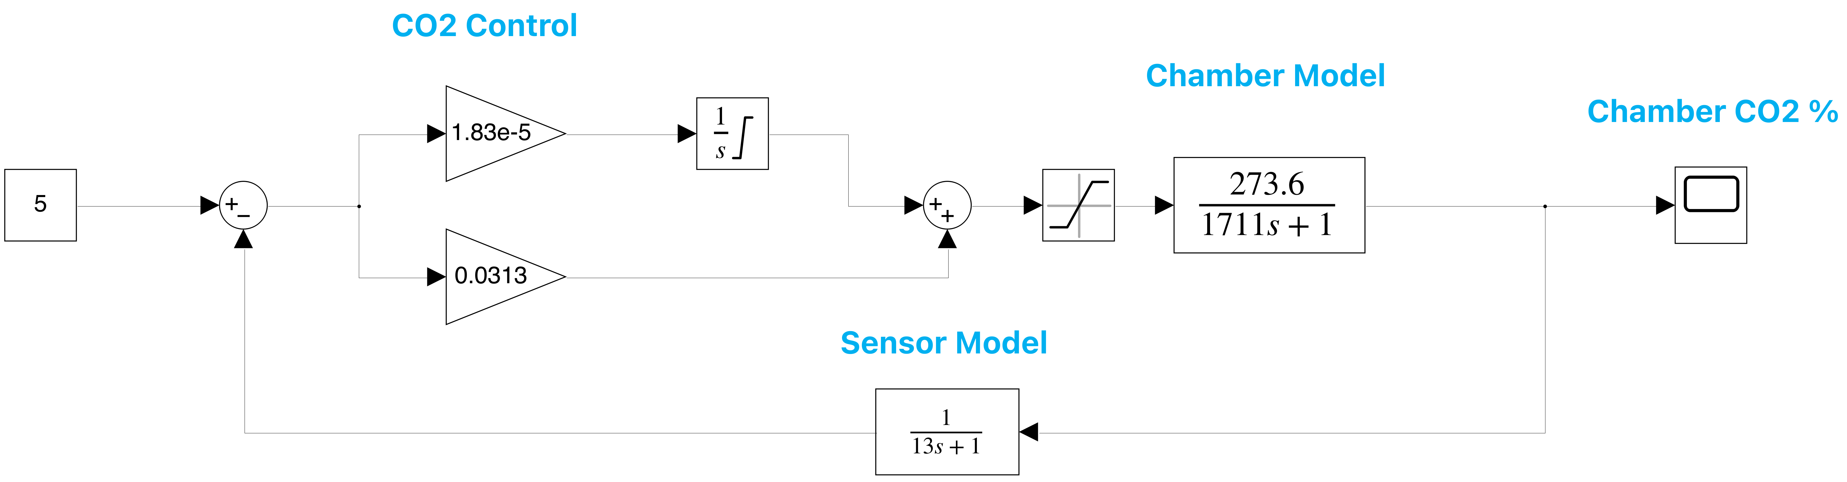
simulation/co2/figures/updated/NEW_fig_C1_simulink.png
