laurenpearse/Stage-Top-Incubator/simulation/co2/figures/updated/NEW_fig_C5_robustness.png

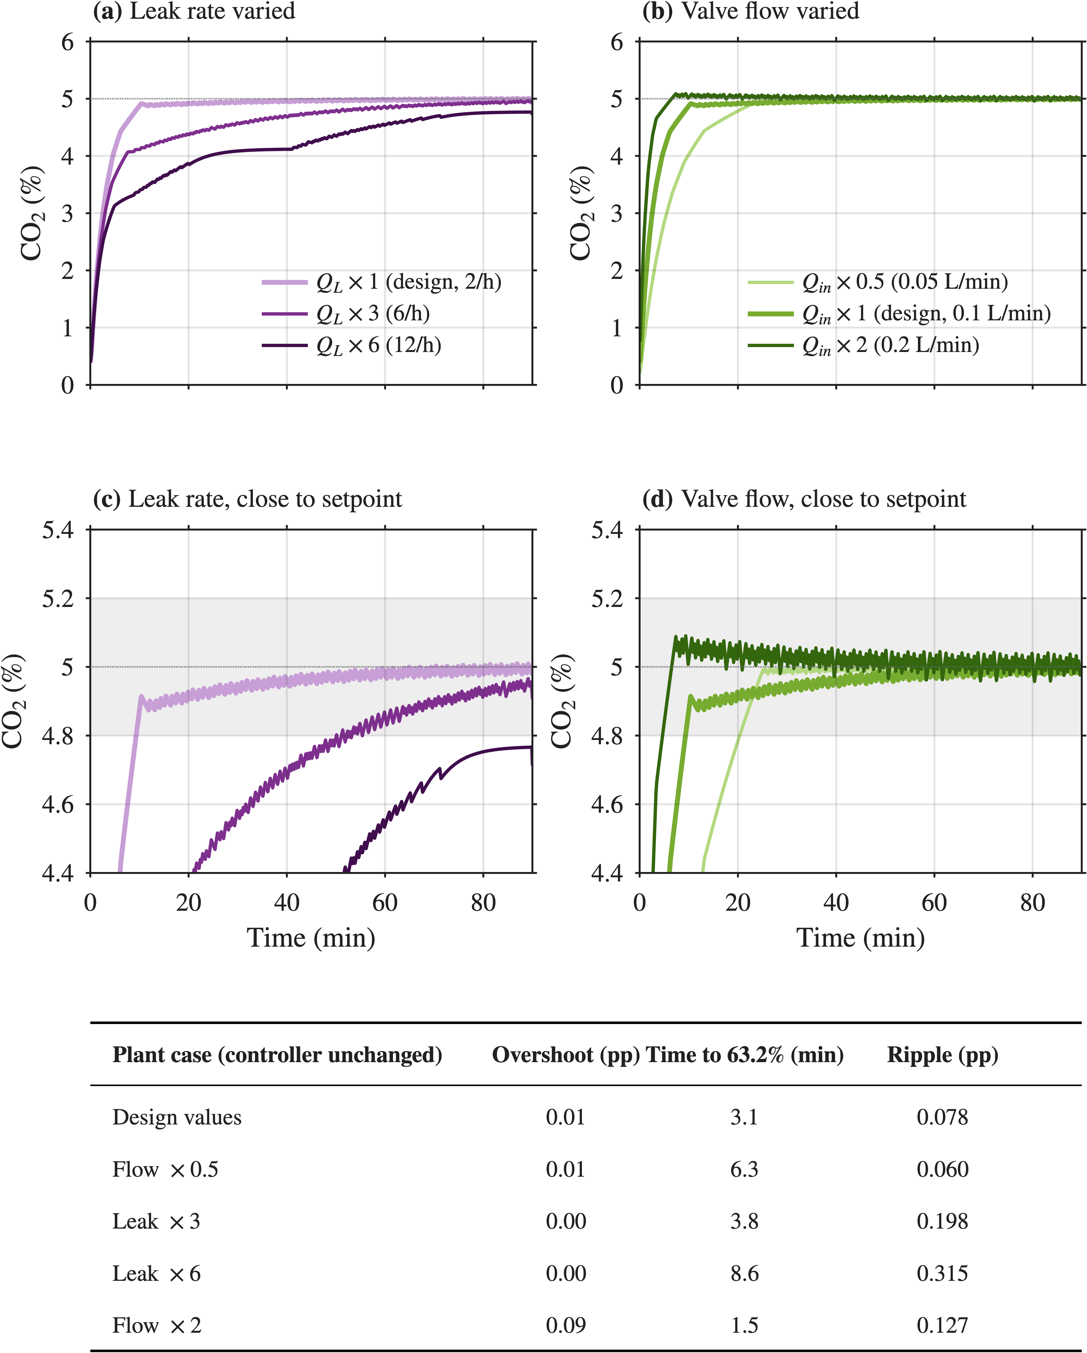
simulation/co2/figures/updated/NEW_fig_C5_robustness.png
