laurenpearse/Stage-Top-Incubator/simulation/co2/figures/updated/NEW_fig_C6_valve_pulses.png

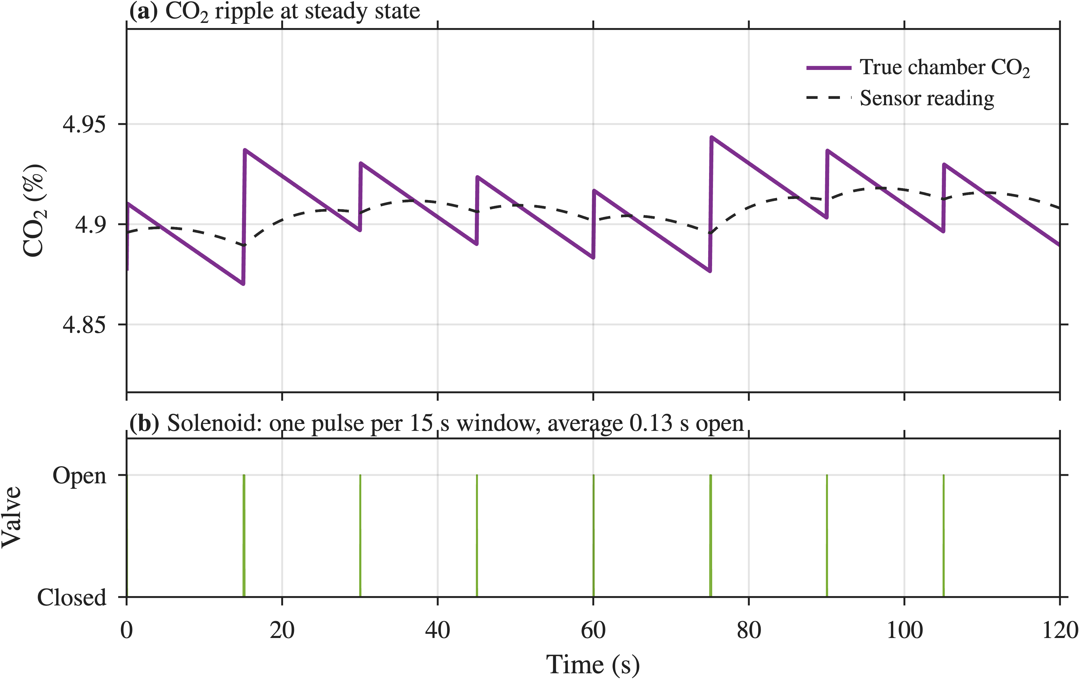
simulation/co2/figures/updated/NEW_fig_C6_valve_pulses.png
