laurenpearse/Stage-Top-Incubator/simulation/co2/figures/updated/NEW_fig_C8_sweeps.png

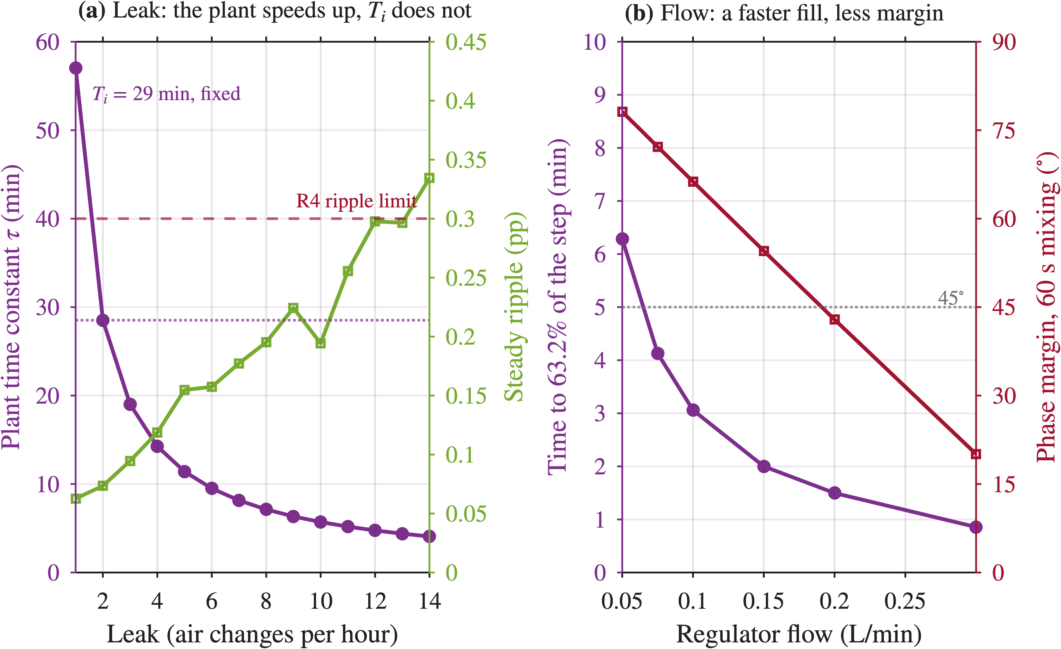
simulation/co2/figures/updated/NEW_fig_C8_sweeps.png
