laurenpearse/Stage-Top-Incubator/simulation/co2/figures/What Each Figure is .png

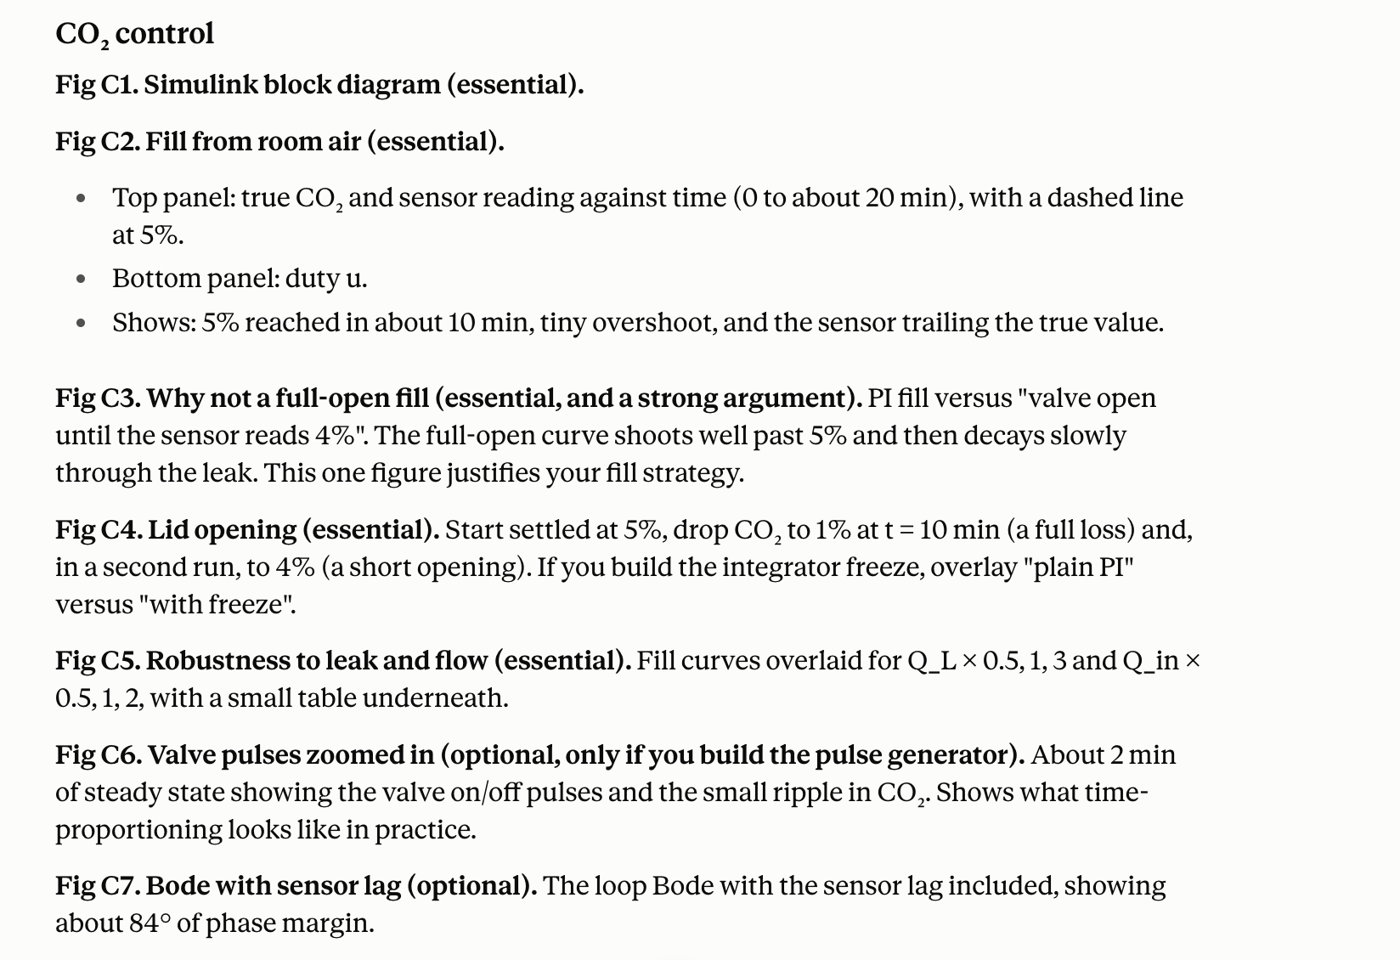
simulation/co2/figures/What Each Figure is .png
