laurenpearse/Stage-Top-Incubator/hardware/bom/initial-component-list-2026-08-27.pdf

## Components To Order

Current Total of Components: R13805

## Sensors

Description | Component | Vendor | Quantity | Cost Per Unit

Cost
Total

Ordered Link

Incubator
Temp
Sensor
Calibrator

PT1000 RTD
Class A, 2
wire, probe
length 5cm

RS
online
1 | R377 | R377 | ✅ | https://z (https://za.rs-online.com/web/p/rtd-sensors/8968399)

ADC for
Temp
Sensor
(PT100)

Adafruit
PT1000 RTD
Temperature
Sensor
Amplifier
MAX31865
DigiKey | 1 | R245 | R245 | ✅ | https://w gclsrc=a (https://www.digikey.co.za/en/products/detail/adafruit-industries-llc/3648/7807995?gclsrc=aw.ds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)

Temp
Sensor for
Well and
Glass and
water and
ambient

THERMISTOR
NTC
10KOHM
3976K BEAD
Digikey | 4 | R245 | R980 | ✅ | https://w gclsrc=a (https://www.digikey.co.za/en/products/detail/te-connectivity-measurement-specialties/GA10K3MCD1/5277239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)

ADC for
thermistors

ADS1115
16BIT ADC
4CH PROG
GAIN
Digikey | 1 | R245 | R245 | ✅ | https://w yiDdIzM (https://www.digikey.co.za/en/products/detail/adafruit-industries-llc/1085/5761229?gclsrc=aw.ds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)

CO2 and
humidity
sensor

SCD30 -
SENSOR
CARBON
DIOXIDE I2C
OUTPUT
Digikey | 1 | R777 | R777 | ✅ | https://w yiDdIzM (https://www.digikey.co.za/en/products/detail/sensirion-ag/SCD30/8445334?gclsrc=aw.ds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)
Total | | | | R2624

## Heaters

Description | Component | Vendor | Quantity | Cost Per Unit

Cost
Total

Ordered

ITO coated | ITO (INDIUM TIN | DigiKey | 1 | R165 | R165 | ✅

Description | Component | Vendor | Quantity | Cost Per Unit

Cost
Total

Ordered

PET film OXIDE) COATED PET
Polyamide
Heating
Strips

20PCS Film Heater
Plate Adhesive Pad
12V 12W 12V 13W,PI
Heating Elements
Film with Cord(12V
12W+12V 13W)
Amazon | 1 | R570 | R570

ITO Coated
Glass

1.1mm ITO
Coated glass
Size:150*112*1.1mm
soda lime glass
substrate
(Tolerance:+/-0.1mm)
safety edge
ITO Coating 5-10
ohm/sq

Konshen
Glass
5 | R2560

Copper
Tape
| Copper Tape | | Konshen
Glass
1 | R96
Total | R3391

CO2

Description | Component | Vendor | Quantity | Cost Per Unit

Cost
Total
Ordered | Lin
CO2 Gas | K cylinder,
gas refill,
delivery
charge and
admin
charge

Air
Products
1 | R1700 | R1700

CO2 Dual
Stage
Regulator

regulator,
solenoid,
check
valve, fine
tuning valve
Connector:
G5/8
Voltage:
220V
McMerwe | 1 | R1628 | R1628 | htt (https://mcmerwe.co.za/shop/lst-aqua-co2-dual-gauge-regulator/)
Tubes | Aquapro
Co2
McMerwe | 1 | R75 | R75 | htt (https://mcmerwe.co.za/shop/aquapro-co2-pressure-resistant-tube-3m/)

Unit

Ordered Lin

Pressure
Resistant
Tube 3M
Relay (for
the
solenoid)

BDD RELAY
BOARD
2CH 3.3V
Communica | 1 | R50 | R50 | htt var rTU (https://www.communica.co.za/products/bdd-relay-board-2ch-3-3v?variant=47620050616620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)

CO2
Sensor for
5%

GAS
SENSING
SOLUTIONS
LTD
ExplorIR-M-20 Carbon
Dioxide Gas
Sensor for
Health Care
System,
Agriculture,
Food
Storage,
RS Online | 1 | R 3 467 | R 3 467 | htt (https://za.rs-online.com/web/p/environmental-sensor-ics/1809026)

Bulkhead
Connector

RS PRO
PMM Series
Pneumatic
Fitting, 6
mm Push-in, 6 mm
Push-in
RS Online | 2 | R134 | R268 | htt _-2 (https://za.rs-online.com/web/p/pneumatic-fittings/2351214?matchtype=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)

Check
Valve

Ista CO2
Stainless
Steel Check
Valve
Mcmerwe | 1 | R98 | R98 | htt (https://mcmerwe.co.za/shop/ista-co2-stainless-steel-check-valve/)
Total | R7286

## Connectors

Description | Component | Vendor | Quantity | Cost Per Unit

Cost
Total

Link

Cable
Gland

RS PRO RS
PRO Series
Metallic
Brass
Cable

RS
online
2 | R60 | R120 ✅

https://za.rs-online.co
_-2084378&matchtyp (https://za.rs-online.com/web/p/cable-glands/2084378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)

Unit

Link

Gland, PG9
Thread, 4
mm min., 8
mm max.,
IP68
Total | | | | R120

## Power

Description | Component | Vendor | Quantity | Cost Per Unit

Cost
Total

Ordered Link

Wall to 12V
, 10A
adaptor

Universal
10A 12V
120W AC
To DC
Adapter
Power
Amazon | 1 | R295 | R295 | http 21&
| | | | 244 (https://www.amazon.co.za/Universal-Adapter-Transformer-Indicator-Voltage/dp/B0FTT3223W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)

Buck
Convertor
12V to uC
Voltage

DC DC
Buck
Converter,
Vin 4-38V ,
Vout 1.25-
36V 8A
MicroRobotics | 1 | R58 | R58 | ✅ | http (https://www.robotics.org.za/XL4016)

Female
adaptor for
power lead
with wires

# 12V DC

Female
Plug
Amazon | 1 | R33 | R33 | http 21&
| | | | 248 (https://www.amazon.co.za/ACDC-Dynamics-12V-Female-Plug/dp/B0CZ4BCXMR?mcid=f94d1f8b74ae36e096803116ac22218d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)
Total | R386
