laurenpearse/Stage-Top-Incubator/hardware/cad/stage-top-incubator.step

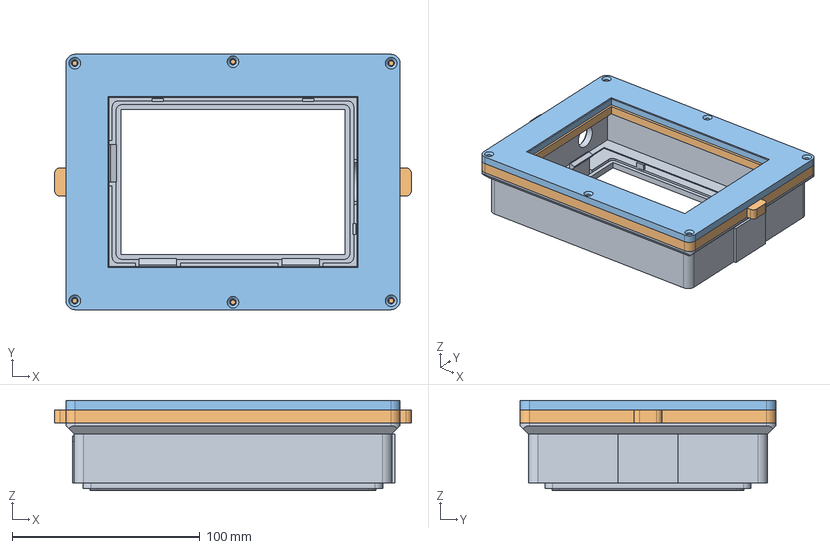
[picture p55: CAD file, 2026-10-26]
hardware/cad/stage-top-incubator.step
190.0 x 136.0 x 48.0 mm
