laurenpearse/Stage-Top-Incubator/data/02-system-identification/fig_T1_heater_step.png

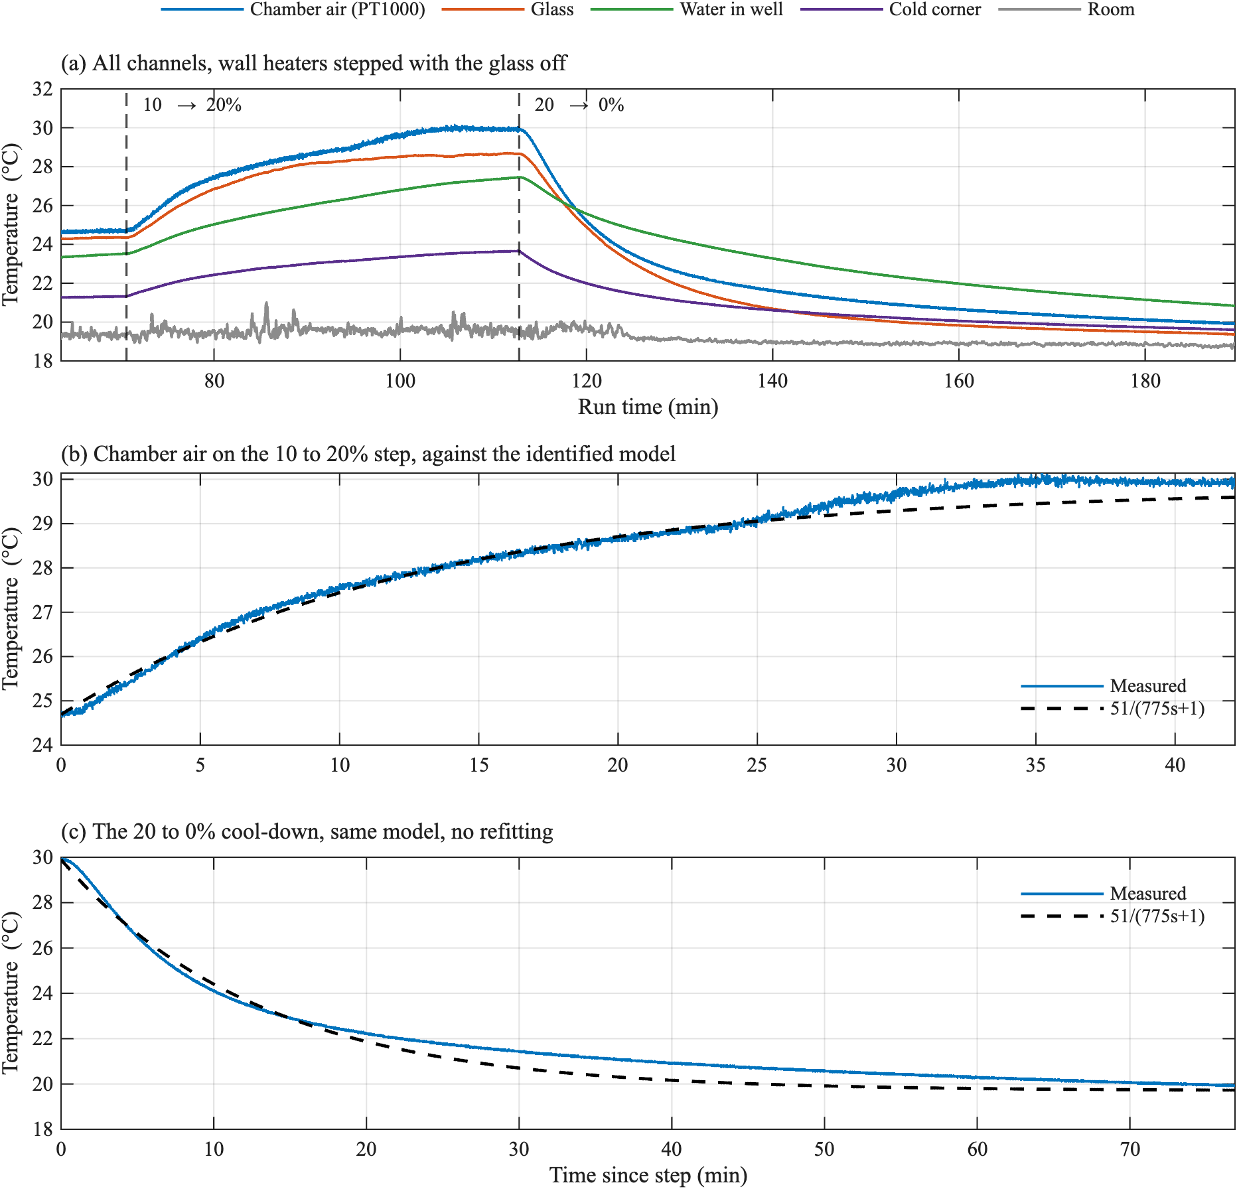
data/02-system-identification/fig_T1_heater_step.png
