laurenpearse/Stage-Top-Incubator/data/characterization/02-system-identification/fig_T2_glass_step.png

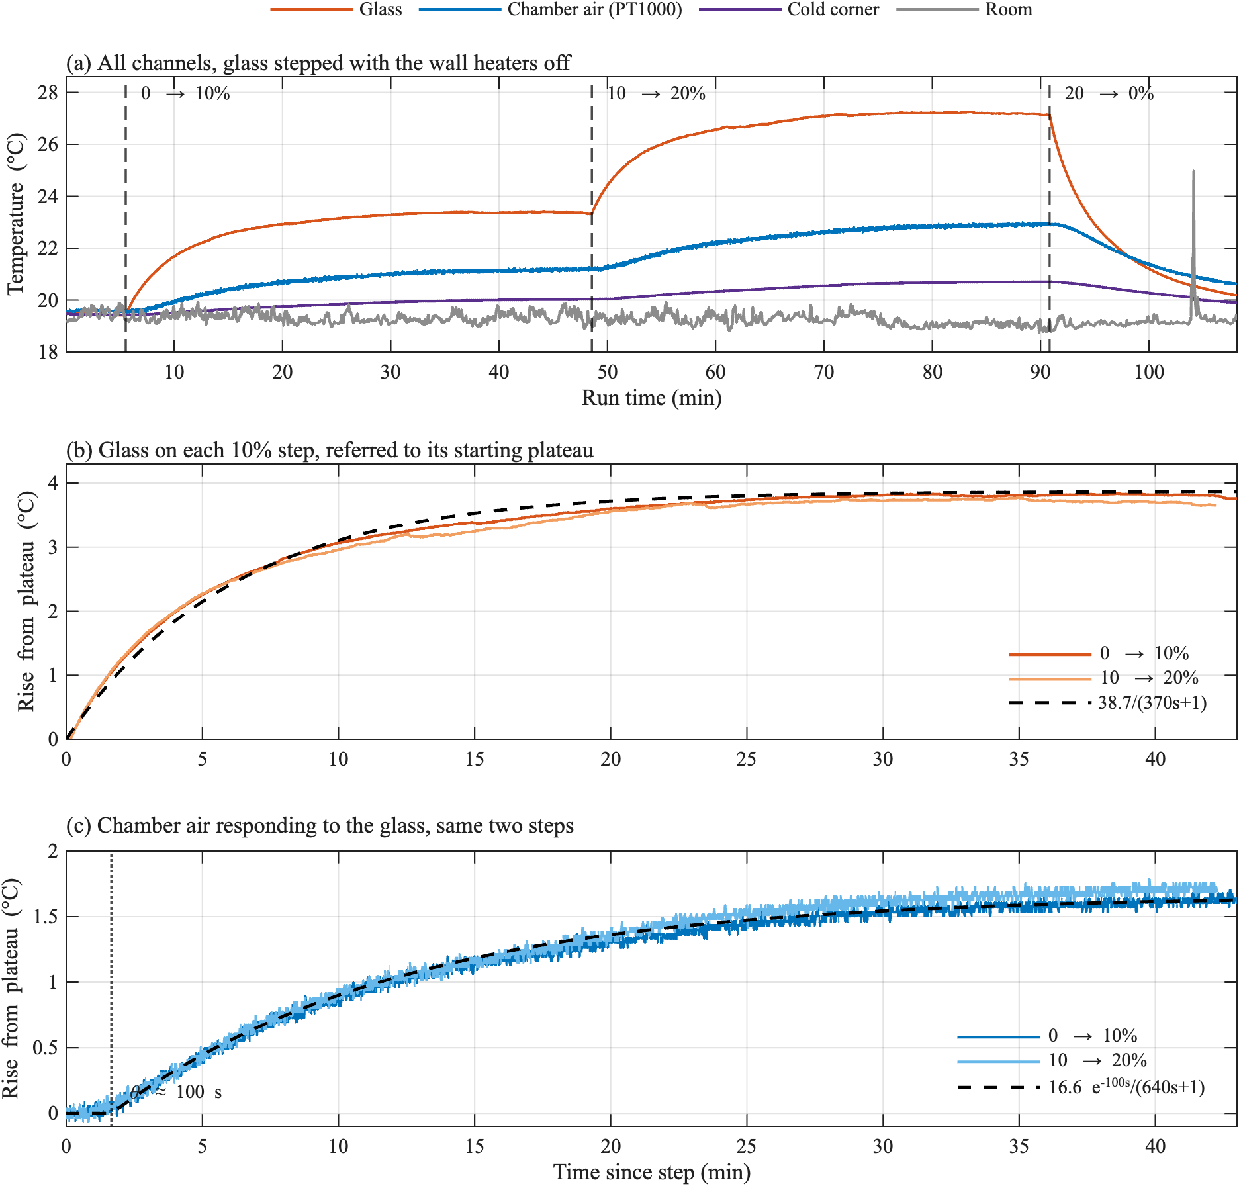
data/characterization/02-system-identification/fig_T2_glass_step.png
