laurenpearse/Stage-Top-Incubator/data/03-closed-loop/heated_base_test1.csv

t_s | mode | heat_pct | glass_pct | base_pct | T_cham | T_glass | T_wellC | T_base | T_amb | marg | flt
3 | OFF | 0.0 | 0.0 | 0.0 | 32.37 | 38.37 | 26.81 | 22.27 | 19.15 | 6.0 | 0.0
4 | OFF | 0.0 | 0.0 | 0.0 | 32.37 | 38.32 | 26.8 | 22.28 | 19.15 | 5.95 | 0.0
5 | OFF | 0.0 | 0.0 | 0.0 | 32.34 | 38.27 | 26.8 | 22.27 | 19.14 | 5.94 | 0.0
6 | OFF | 0.0 | 0.0 | 0.0 | 32.34 | 38.23 | 26.8 | 22.27 | 19.14 | 5.89 | 0.0
7 | OFF | 0.0 | 0.0 | 0.0 | 32.34 | 38.18 | 26.8 | 22.27 | 19.15 | 5.84 | 0.0
8 | OFF | 0.0 | 0.0 | 0.0 | 32.3 | 38.13 | 26.8 | 22.27 | 19.17 | 5.82 | 0.0
9 | OFF | 0.0 | 0.0 | 0.0 | 32.3 | 38.08 | 26.8 | 22.28 | 19.16 | 5.77 | 0.0
10 | OFF | 0.0 | 0.0 | 0.0 | 32.27 | 38.03 | 26.8 | 22.29 | 19.15 | 5.76 | 0.0
11 | OFF | 0.0 | 0.0 | 0.0 | 32.27 | 37.98 | 26.8 | 22.29 | 19.13 | 5.71 | 0.0
12 | OFF | 0.0 | 0.0 | 0.0 | 32.24 | 37.94 | 26.8 | 22.3 | 19.12 | 5.7 | 0.0
13 | OFF | 0.0 | 0.0 | 0.0 | 32.2 | 37.9 | 26.8 | 22.3 | 19.12 | 5.7 | 0.0
14 | OFF | 0.0 | 0.0 | 0.0 | 32.2 | 37.86 | 26.8 | 22.3 | 19.13 | 5.66 | 0.0
15 | OFF | 0.0 | 0.0 | 0.0 | 32.2 | 37.81 | 26.8 | 22.31 | 19.57 | 5.61 | 0.0
16 | OFF | 0.0 | 0.0 | 0.0 | 32.2 | 37.76 | 26.8 | 22.31 | 20.09 | 5.56 | 0.0
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
