laurenpearse/Stage-Top-Incubator/data/01-sensor-commissioning/pt1000_ice_bath_test1.csv

time_s | resistance_ohm | temperature_C
0.1 | 1073.56 | 18.87
1.1 | 1073.56 | 18.87
2.1 | 1073.56 | 18.87
3.1 | 1073.56 | 18.87
4.1 | 1073.56 | 18.87
5.1 | 1073.56 | 18.87
6.1 | 1073.56 | 18.87
7.1 | 1073.56 | 18.87
8.1 | 1073.43 | 18.84
9.1 | 1073.43 | 18.84
10.1 | 1073.56 | 18.87
11.1 | 1072.51 | 18.60
12.1 | 1070.80 | 18.16
13.1 | 1067.26 | 17.25
14.1 | 1063.85 | 16.38
15.1 | 1060.43 | 15.50
16.1 | 1057.42 | 14.72
17.1 | 1054.53 | 13.98
18.1 | 1051.90 | 13.31
19.1 | 1049.41 | 12.67
20.1 | 1047.05 | 12.06
21.1 | 1044.82 | 11.49
22.1 | 1042.72 | 10.95
23.1 | 1040.75 | 10.44
24.1 | 1038.91 | 9.97
25.1 | 1037.21 | 9.53
26.1 | 1035.50 | 9.10
27.1 | 1033.93 | 8.69
28.1 | 1032.48 | 8.32
29.1 | 1031.04 | 7.95
30.1 | 1029.60 | 7.58
31.1 | 1028.15 | 7.21
32.1 | 1026.71 | 6.84
33.1 | 1025.53 | 6.54
34.1 | 1024.22 | 6.20
35.1 | 1023.03 | 5.90
36.1 | 1021.85 | 5.60
37.1 | 1020.80 | 5.33
38.1 | 1019.75 | 5.06
39.1 | 1018.70 | 4.79
40.1 | 1017.92 | 4.59
41.1 | 1017.13 | 4.39
42.1 | 1016.34 | 4.18
43.1 | 1015.55 | 3.98
44.1 | 1014.90 | 3.81
45.1 | 1014.24 | 3.65
46.1 | 1013.59 | 3.48
47.1 | 1012.93 | 3.31
48.1 | 1012.41 | 3.18
49.1 | 1011.88 | 3.04
50.1 | 1011.49 | 2.94
51.1 | 1010.96 | 2.81
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
