laurenpearse/Stage-Top-Incubator/data/01-sensor-commissioning/scd30_breath_test.csv

elapsed_time | elapsed_s | co2_ppm | temp_c | rh_percent
00:00:01 | 1 | 593 | 22.7 | 53.8
00:00:03 | 3 | 594 | 22.7 | 54.1
00:00:05 | 5 | 595 | 22.7 | 54.1
00:00:07 | 7 | 596 | 22.7 | 54.0
00:00:09 | 9 | 595 | 22.7 | 54.0
00:00:11 | 11 | 595 | 22.6 | 54.0
00:00:13 | 13 | 593 | 22.7 | 54.0
00:00:16 | 16 | 590 | 22.6 | 53.9
00:00:18 | 18 | 591 | 22.6 | 54.0
00:00:20 | 20 | 615 | 22.6 | 53.9
00:00:22 | 22 | 700 | 23.3 | 61.5
00:00:24 | 24 | 810 | 22.8 | 72.2
00:00:26 | 26 | 946 | 22.7 | 73.2
00:00:28 | 28 | 1213 | 22.8 | 68.9
00:00:31 | 31 | 1747 | 22.7 | 64.5
00:00:33 | 33 | 2117 | 22.7 | 61.8
00:00:35 | 35 | 1964 | 22.7 | 59.9
00:00:37 | 37 | 1874 | 22.7 | 58.4
00:00:39 | 39 | 1697 | 22.7 | 57.3
00:00:41 | 41 | 1493 | 22.6 | 56.5
00:00:43 | 43 | 1376 | 22.6 | 55.9
00:00:45 | 45 | 1195 | 22.6 | 55.6
00:00:48 | 48 | 1115 | 22.6 | 55.3
00:00:50 | 50 | 1073 | 22.6 | 55.1
00:00:52 | 52 | 1000 | 22.6 | 54.8
00:00:54 | 54 | 901 | 22.6 | 54.8
00:00:56 | 56 | 850 | 22.6 | 54.8
00:00:58 | 58 | 826 | 22.6 | 54.8
00:01:01 | 61 | 804 | 22.6 | 54.8
00:01:03 | 63 | 779 | 22.6 | 54.8
00:01:05 | 65 | 752 | 22.6 | 54.7
00:01:07 | 67 | 737 | 22.6 | 54.7
00:01:09 | 69 | 722 | 22.6 | 54.6
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
