laurenpearse/Stage-Top-Incubator/data/01-sensor-commissioning/thermistor_comparison_test.csv

elapsed_time | elapsed_s | T1_A0_c | T2_A1_c | T3_A2_c | T4_A3_c
00:00:01 | 1 | 23.1 | 23.1 | 23.42 | 23.47
00:00:02 | 2 | 22.95 | 22.78 | 23.2 | 23.28
00:00:04 | 4 | 22.74 | 22.59 | 23.15 | 23.28
00:00:05 | 5 | 22.93 | 22.81 | 23.35 | 23.48
00:00:07 | 7 | 23.09 | 22.89 | 23.47 | 23.57
00:00:09 | 9 | 23.16 | 22.89 | 23.5 | 23.58
00:00:10 | 10 | 23.06 | 22.79 | 23.46 | 23.55
00:00:12 | 12 | 23.22 | 22.84 | 23.6 | 23.66
00:00:13 | 13 | 23.39 | 22.92 | 23.69 | 23.65
00:00:15 | 15 | 23.48 | 22.92 | 23.68 | 23.61
00:00:17 | 17 | 23.4 | 22.8 | 23.6 | 23.52
00:00:18 | 18 | 23.09 | 22.54 | 23.38 | 23.35
00:00:20 | 20 | 22.88 | 22.39 | 23.26 | 23.3
00:00:21 | 21 | 23.0 | 22.65 | 23.4 | 23.47
00:00:23 | 23 | 23.05 | 22.71 | 23.41 | 23.44
00:00:24 | 24 | 22.98 | 22.59 | 23.27 | 23.34
00:00:26 | 26 | 22.9 | 22.49 | 23.2 | 23.25
00:00:28 | 28 | 22.83 | 22.43 | 23.13 | 23.14
00:00:29 | 29 | 22.7 | 22.28 | 23.01 | 23.03
00:00:31 | 31 | 22.66 | 22.23 | 22.94 | 22.97
00:00:32 | 32 | 22.66 | 22.25 | 22.96 | 22.94
00:00:34 | 34 | 22.73 | 22.39 | 23.09 | 23.07
00:00:36 | 36 | 22.75 | 22.37 | 23.04 | 23.09
00:00:37 | 37 | 22.72 | 22.4 | 23.11 | 23.25
00:00:39 | 39 | 22.78 | 22.56 | 23.27 | 23.48
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
