laurenpearse/Stage-Top-Incubator/data/01-sensor-commissioning/thermistor_vs_pt1000_calibrated.csv

elapsed_time | elapsed_s | PT1000_c | T1_A0_c | T2_A1_c | T3_A2_c | T4_A3_c
00:00:02 | 2 | 23.67 | 23.54 | 23.38 | 23.37 | 23.43
00:00:03 | 3 | 23.67 | 23.5 | 23.36 | 23.36 | 23.43
00:00:04 | 4 | 23.67 | 23.53 | 23.34 | 23.34 | 23.41
00:00:05 | 5 | 23.67 | 23.58 | 23.34 | 23.36 | 23.44
00:00:06 | 6 | 23.67 | 23.65 | 23.42 | 23.43 | 23.52
00:00:07 | 7 | 23.67 | 23.75 | 23.57 | 23.57 | 23.66
00:00:08 | 8 | 23.67 | 23.84 | 23.71 | 23.71 | 23.78
00:00:09 | 9 | 23.67 | 23.88 | 23.81 | 23.8 | 23.84
00:00:10 | 10 | 23.7 | 23.86 | 23.85 | 23.81 | 23.81
00:00:11 | 11 | 23.67 | 23.76 | 23.79 | 23.74 | 23.73
00:00:12 | 12 | 23.67 | 23.73 | 23.79 | 23.75 | 23.74
00:00:13 | 13 | 23.67 | 23.75 | 23.8 | 23.77 | 23.76
00:00:14 | 14 | 23.7 | 23.74 | 23.81 | 23.77 | 23.78
00:00:15 | 15 | 23.7 | 23.77 | 23.84 | 23.81 | 23.82
00:00:16 | 16 | 23.67 | 23.79 | 23.85 | 23.83 | 23.79
00:00:17 | 17 | 23.67 | 23.62 | 23.69 | 23.72 | 23.69
00:00:18 | 18 | 23.67 | 23.63 | 23.69 | 23.73 | 23.73
00:00:19 | 19 | 23.7 | 23.66 | 23.73 | 23.74 | 23.7
00:00:20 | 20 | 23.7 | 23.59 | 23.64 | 23.61 | 23.52
00:00:21 | 21 | 23.7 | 23.43 | 23.49 | 23.49 | 23.42
00:00:22 | 22 | 23.67 | 23.42 | 23.43 | 23.39 | 23.29
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
