laurenpearse/Stage-Top-Incubator/data/characterization/01-sensor-commissioning/explorir_breath_test.csv

elapsed_time | elapsed_s | raw | co2_ppm | co2_percent
00:00:02 | 2 | 5 | 500 | 0.05
00:00:03 | 3 | 5 | 500 | 0.05
00:00:04 | 4 | 5 | 500 | 0.05
00:00:05 | 5 | 5 | 500 | 0.05
00:00:06 | 6 | 5 | 500 | 0.05
00:00:07 | 7 | 5 | 500 | 0.05
00:00:08 | 8 | 5 | 500 | 0.05
00:00:09 | 9 | 5 | 500 | 0.05
00:00:10 | 10 | 5 | 500 | 0.05
00:00:11 | 11 | 5 | 500 | 0.05
00:00:12 | 12 | 5 | 500 | 0.05
00:00:13 | 13 | 5 | 500 | 0.05
00:00:14 | 14 | 5 | 500 | 0.05
00:00:15 | 15 | 5 | 500 | 0.05
00:00:16 | 16 | 5 | 500 | 0.05
00:00:17 | 17 | 5 | 500 | 0.05
00:00:18 | 18 | 5 | 500 | 0.05
00:00:19 | 19 | 5 | 500 | 0.05
00:00:20 | 20 | 5 | 500 | 0.05
00:00:21 | 21 | 5 | 500 | 0.05
00:00:22 | 22 | 6 | 600 | 0.06
00:00:23 | 23 | 7 | 700 | 0.07
00:00:24 | 24 | 8 | 800 | 0.08
00:00:25 | 25 | 9 | 900 | 0.09
00:00:26 | 26 | 10 | 1000 | 0.10
00:00:27 | 27 | 11 | 1100 | 0.11
00:00:28 | 28 | 13 | 1300 | 0.13
00:00:29 | 29 | 14 | 1400 | 0.14
00:00:30 | 30 | 15 | 1500 | 0.15
00:00:31 | 31 | 15 | 1500 | 0.15
00:00:32 | 32 | 16 | 1600 | 0.16
00:00:33 | 33 | 16 | 1600 | 0.16
00:00:34 | 34 | 16 | 1600 | 0.16
00:00:35 | 35 | 16 | 1600 | 0.16
00:00:36 | 36 | 16 | 1600 | 0.16
00:00:37 | 37 | 16 | 1600 | 0.16
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
