laurenpearse/Stage-Top-Incubator/data/02-system-identification/fig_T3_model_vs_measured.png

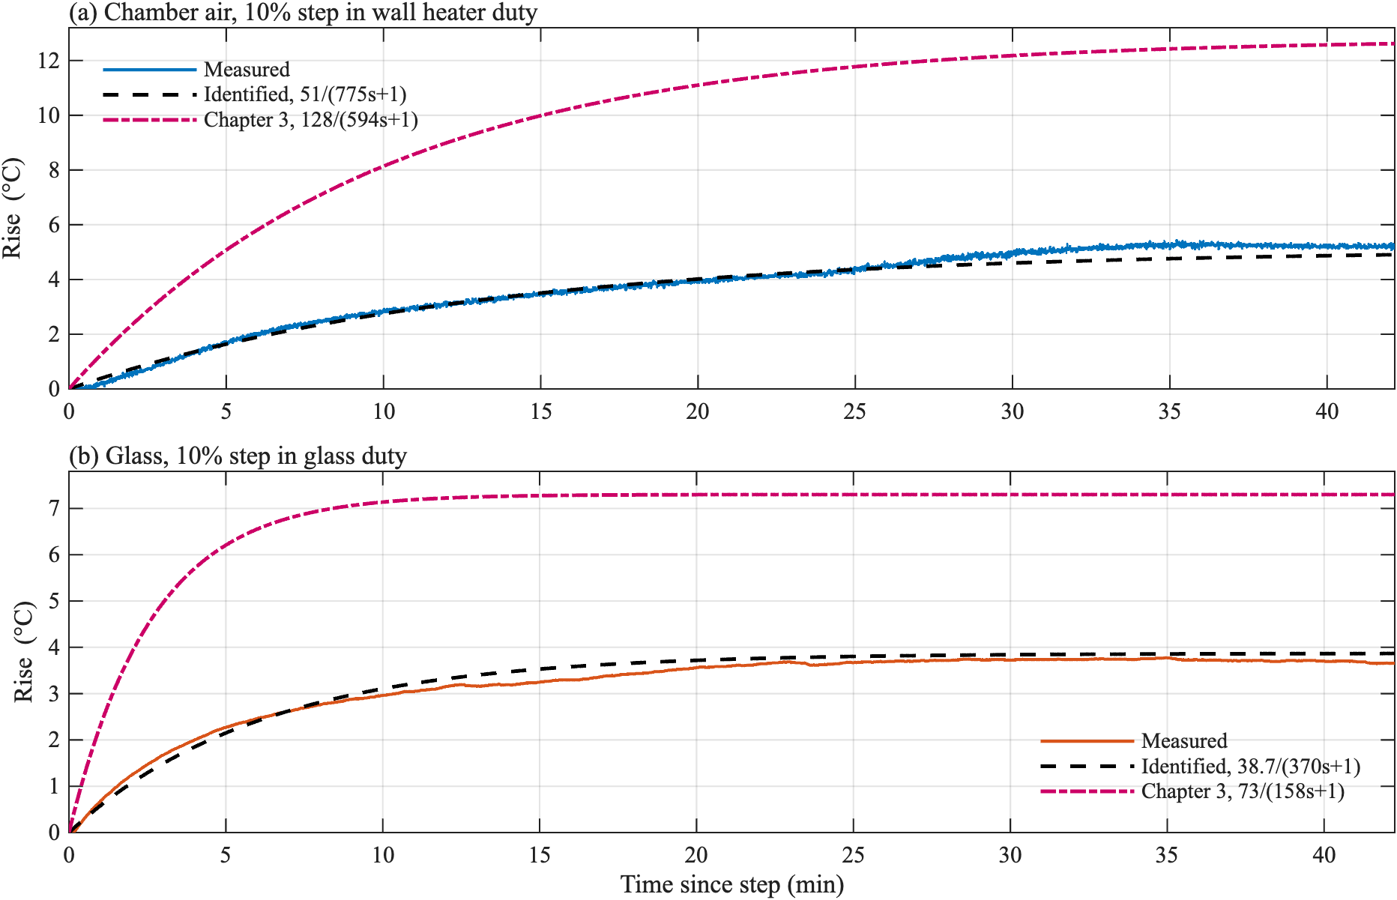
data/02-system-identification/fig_T3_model_vs_measured.png
