laurenpearse/Stage-Top-Incubator/data/characterization/04-humidity-long-run/fig_H1_long_run.png

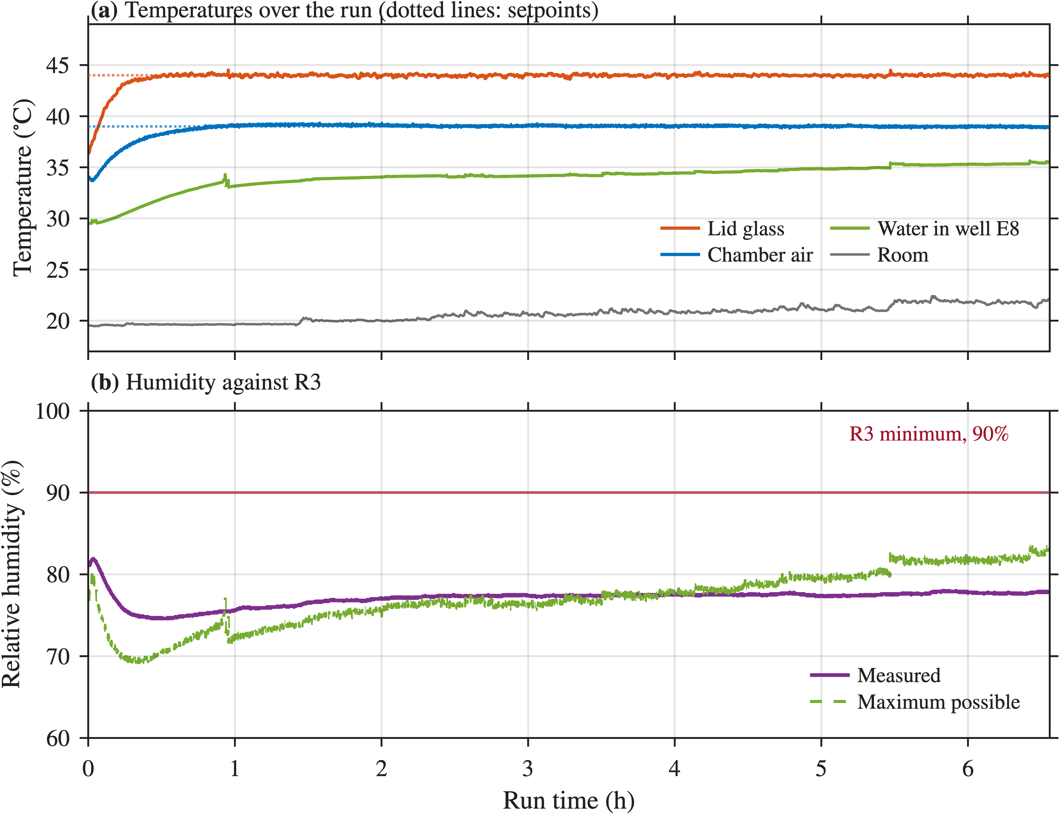
data/characterization/04-humidity-long-run/fig_H1_long_run.png
