laurenpearse/Stage-Top-Incubator/docs/thesis/latex/figs/ch5/fig_M1_thermistor_calibration.png

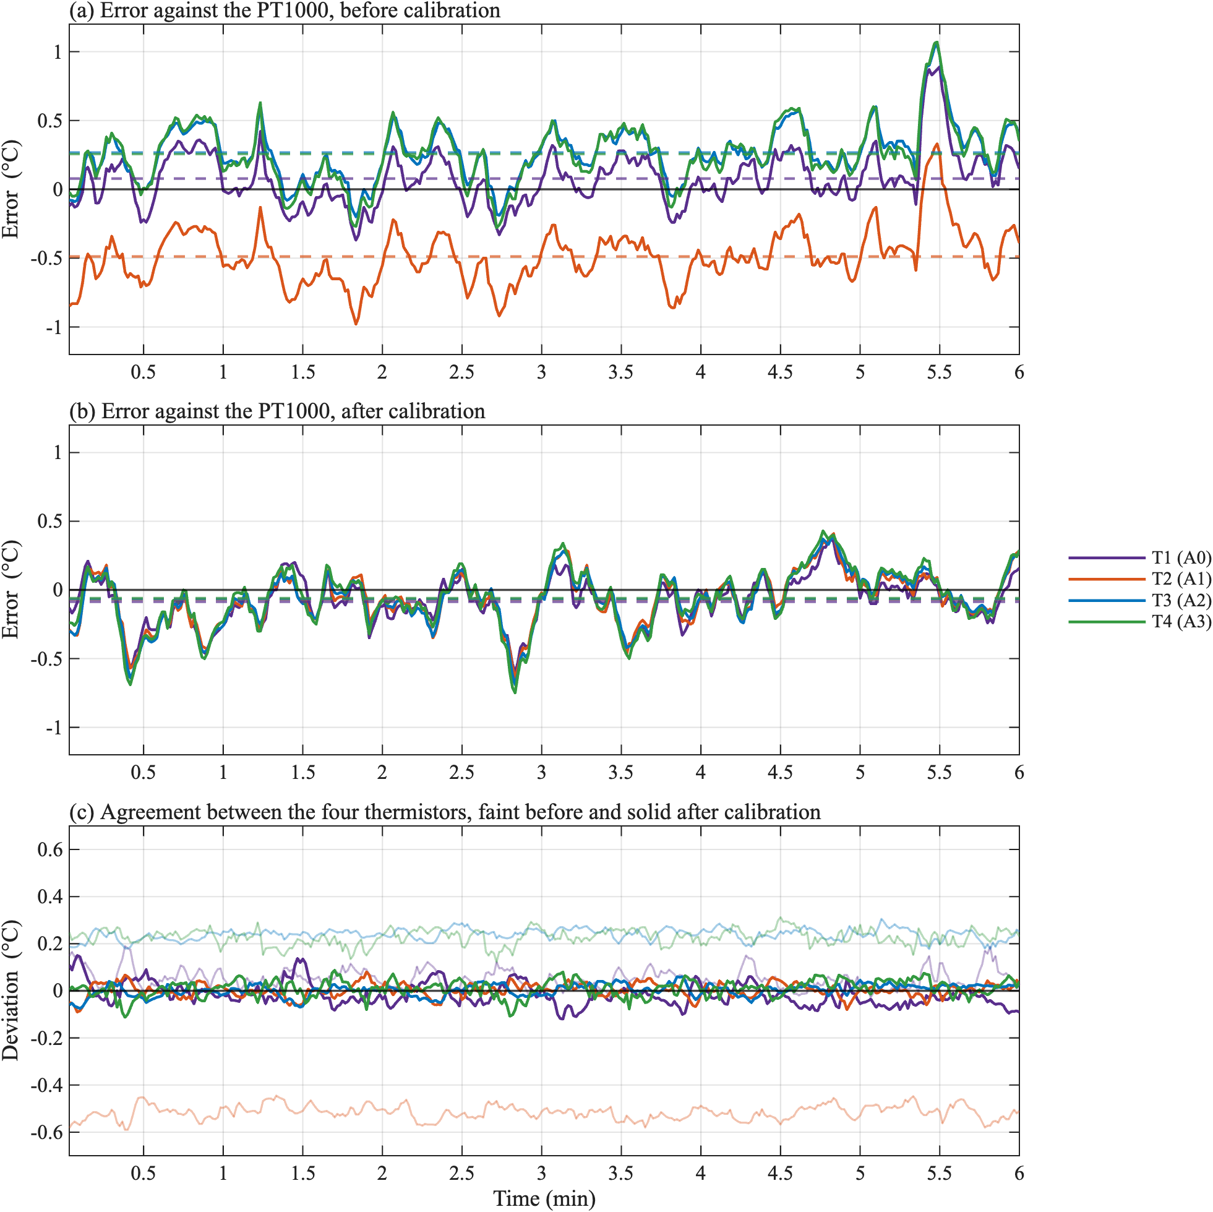
docs/thesis/latex/figs/ch5/fig_M1_thermistor_calibration.png
