laurenpearse/Stage-Top-Incubator/docs/thesis/latex/figs/ch6/test-setup.jpeg

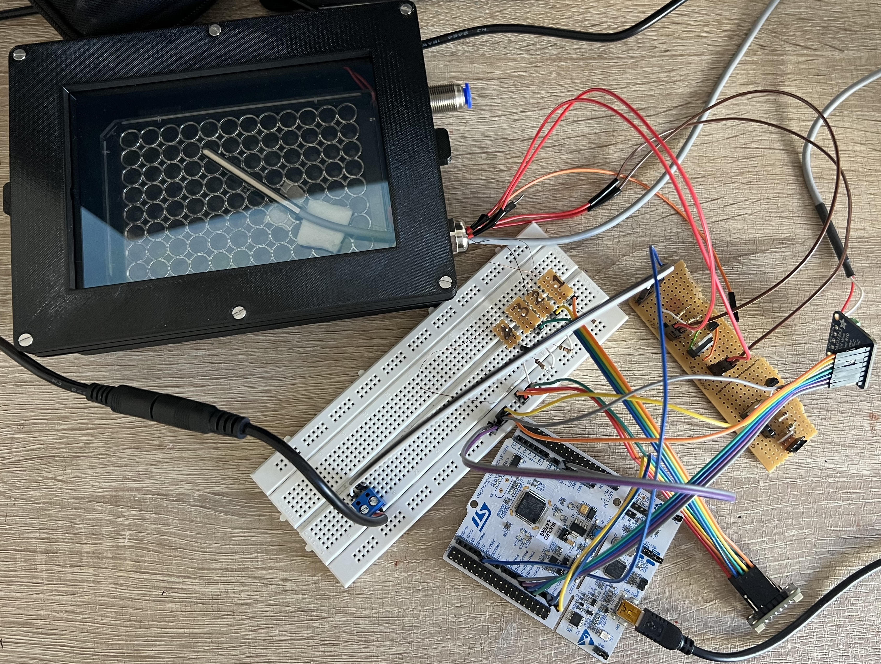
docs/thesis/latex/figs/ch6/test-setup.jpeg
