laurenpearse/Stage-Top-Incubator/report/figs/ch4/System Diagram.pdf

# Incubator Enclosure Humidifier

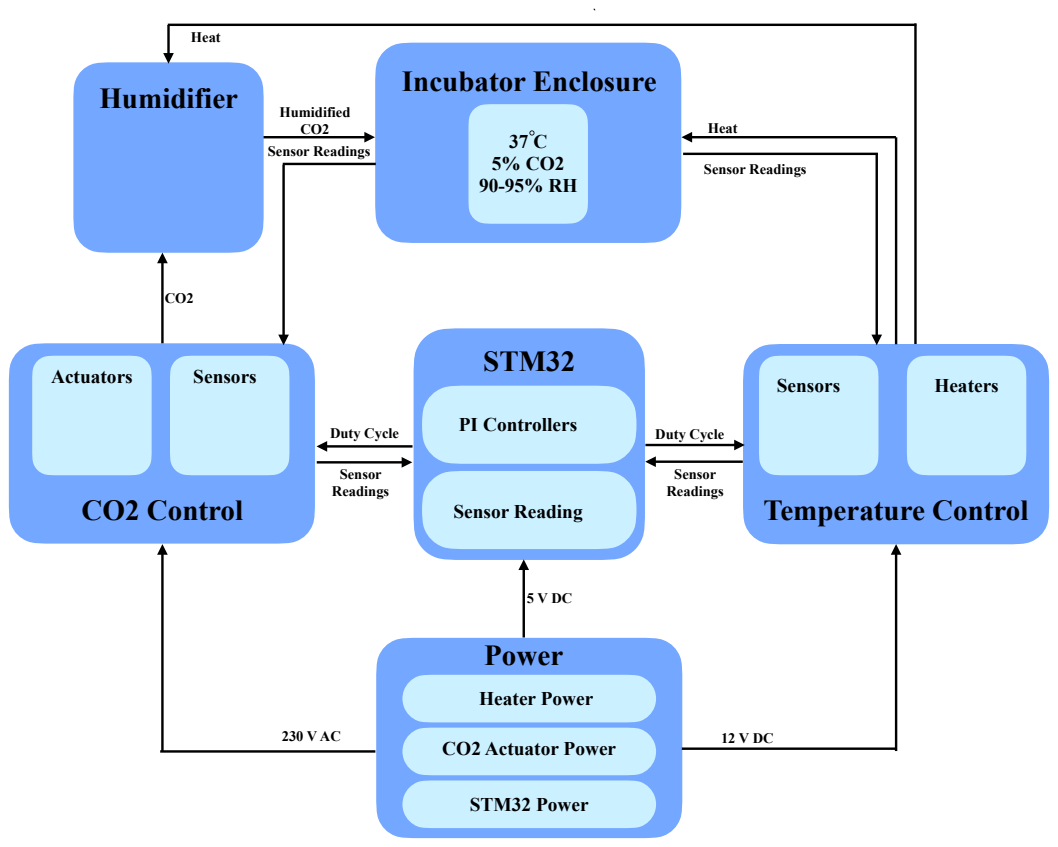
[picture p62: page 1]
STM32; CO2 Control; Temperature Control; Power; Sensors; Heaters Actuators; PI Controllers; Sensor Reading; Heater Power; CO2 Actuator Power; STM32 Power; Duty Cycle; Humidified; Heat; Sensor Readings
