laurenpearse/Stage-Top-Incubator/report/figs/ch4/Temperature Control.pdf

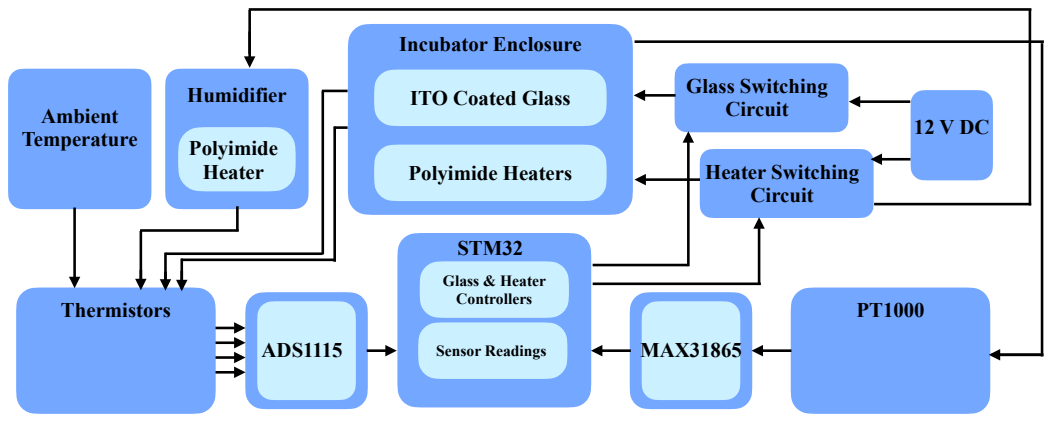
[picture p63: page 1]
Incubator Enclosure; Polyimide Heaters; STM32; Thermistors; ADS1115; MAX31865; Ambient Temperature; Humidifier; Sensor Readings; Glass & Heater Controllers; Glass Switching Circuit; Heater Switching Circuit; Polyimide Heater

ITO Coated Glass
