laurenpearse/Stage-Top-Incubator/docs/thesis/latex/figs/ch4/CO2 Control.pdf

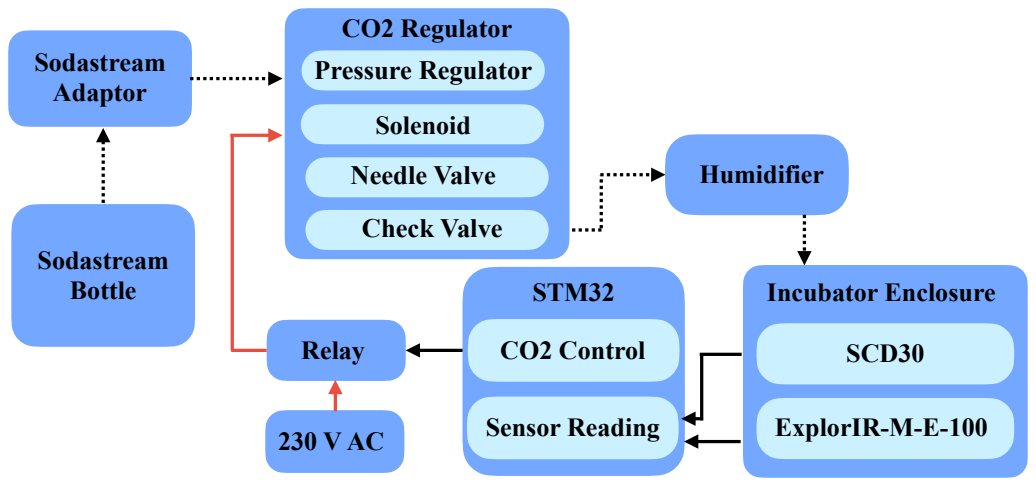
[picture p64: page 1]
STM32; Sodastream Bottle; Relay; CO2 Regulator; Solenoid; Incubator Enclosure; SCD30; ExplorIR-M-E-100; Sodastream Adaptor; CO2 Control; Humidifier; Sensor Reading; Pressure Regulator; Needle Valve; Check Valve
