laurenpearse/Stage-Top-Incubator/(commit log)

2026-08-27 Add files via upload
    Rough Notes on Sensor Selection
2026-10-07 Add STM32 subsystem testing firmware
2026-10-26 Add remaining STM32 subsystem test projects and firmware README
    Adds DHT22 Humidity, Humidity Sensor (BMP280) and SCD30 and ADC1115
    projects with their serial logs, updates SCD30 Readings to the latest
    version, and replaces the firmware README with an index of the projects.
2026-10-26 Add enclosure CAD (STEP)
